antoraja/robo-to-roll/docs/02b-amazon-de.md

# 02b · Einkaufsliste / shopping list: amazon.de

Every link opens an **amazon.de search** for the right item, so you can pick a current
offer with good reviews. Prices are typical amazon.de prices (Nov 2026) and change often.

> **Why search links instead of single products?** Listings on amazon.de change and sell out
> all the time, and the exact product pages couldn't be checked from here. A search link
> always works. The "Pick" column says what to look for in the listing.

## Buy now: full hand (≈ €40–55)

| # | Item | Qty | Link | Pick | ≈ € |
|---|---|---|---|---|---|
| 1 | **MG90S servo**, metal gear, pack of 5–6 | 6 | [amazon.de: MG90S Servo 6 Stück](https://www.amazon.de/s?k=MG90S+Servo+Metallgetriebe+6+St%C3%BCck) | "MG90S" + "Metallgetriebe". Not SG90 (plastic gears) | 15–20 |
| 2 | **ESP32 DevKit** (ESP-WROOM-32, 30 pins) | 1 | [amazon.de: ESP32 NodeMCU Development Board](https://www.amazon.de/s?k=ESP32+NodeMCU+Development+Board+WROOM-32+30+pin) | AZ-Delivery or similar, **USB-C** if offered. A 2–3 pack is often only slightly more | 7–10 |
| 3 | **Jumper wires** M-M, M-F, F-F | 1 set | [amazon.de: Jumper Kabel Set](https://www.amazon.de/s?k=Jumper+Kabel+Set+male+female+120+St%C3%BCck) | **20 cm** (e.g. Elegoo 120 pcs). Only male-male is used: the ESP32 plugs into the breadboard, and 20 cm jumpers extend the 20 cm servo leads | 5–7 |
| 4 | **Breadboard**, 400 holes | 1 | [amazon.de: Breadboard 400](https://www.amazon.de/s?k=Breadboard+400+Kontakte) | 400 points (fits the tray in the stand). Packs of 3 are fine | 4–6 |
| 5 | **5 V / 3 A power supply** (barrel plug) | 1 | [amazon.de: Netzteil 5V 3A Hohlstecker](https://www.amazon.de/s?k=Netzteil+5V+3A+5.5x2.1+Hohlstecker) | 5.5 × 2.1 mm plug, ≥ 3 A | 8–11 |
| 6 | **DC socket → screw terminal adapter** | 1 | [amazon.de: DC Buchse Schraubklemme Adapter](https://www.amazon.de/s?k=DC+Buchse+5.5x2.1+Schraubklemme+Adapter) | Female 5.5 × 2.1 mm, packs of 5–10 | 4–6 |
| 7 | **Capacitor 1000 µF, 16 V** (Elko) | 1 | [amazon.de: Elko 1000uF 16V](https://www.amazon.de/s?k=Elko+1000uF+16V) | Any small pack | 4–6 |
| 8 | **Braided fishing line** 0.25–0.35 mm | 1 | [amazon.de: geflochtene Angelschnur 0,30 mm](https://www.amazon.de/s?k=geflochtene+Angelschnur+0%2C30mm) | **Geflochten** (braided PE), not monofil | 8–12 |
| 9 | **Round elastic cord, 2 mm** | 1 | [amazon.de: Gummikordel rund 2 mm](https://www.amazon.de/s?k=Gummikordel+rund+2mm) | Round, rubber core, 2 mm (also sold as "Hutgummi 2mm") | 5–7 |
| 10 | **USB data cable** for the ESP32 | 1 | [amazon.de: USB C Datenkabel](https://www.amazon.de/s?k=USB+C+Datenkabel+kurz) | Match your board (USB-C or Micro-USB). It must say **Daten** (data). You probably have one | 0–6 |

**Already at home:** PLA (~330 g), 1.75 mm filament for the pins, super glue
(Sekundenkleber), a lighter, a small Phillips screwdriver, scissors, and 4 coins (2-euro
coins fit the stand's pockets).

## Camera in the palm (guide 06, ≈ €15–20)

| Item | Link | Pick | ≈ € |
|---|---|---|---|
| **ESP32-CAM with ESP32-CAM-MB** programmer | [amazon.de: ESP32-CAM MB](https://www.amazon.de/s?k=ESP32-CAM+MB+OV2640) | AI-Thinker ESP32-CAM **with** the MB USB board | 10–14 |
| **Jumper wires female-male, 40 cm** | [amazon.de: Jumper Kabel female male 40cm](https://www.amazon.de/s?k=Jumper+Kabel+female+male+40cm) | 2 needed (5 V + GND up to the palm) | 4–6 |

## Optional, saves time

| Item | Link | ≈ € |
|---|---|---|
| Servo extension cables 30 cm (neater than jumper wires; not required) | [amazon.de: Servo Verlängerungskabel 30cm](https://www.amazon.de/s?k=Servo+Verl%C3%A4ngerungskabel+30cm) | 5–7 |
| 2 mm drill bit (cleans tight pin holes) | [amazon.de: Bohrer 2mm HSS](https://www.amazon.de/s?k=HSS+Bohrer+2mm) | 4–6 |
| Cheap multimeter | [amazon.de: Multimeter digital](https://www.amazon.de/s?k=Multimeter+digital+g%C3%BCnstig) | 10–15 |
| Hot glue gun (non-slip feet, grip pads) | [amazon.de: Heißklebepistole klein](https://www.amazon.de/s?k=Hei%C3%9Fklebepistole+klein) | 8–12 |

## Later: rolling stage (don't buy yet)

| Item | Link | ≈ € |
|---|---|---|
| Manual rolling machine, 70 mm | [amazon.de: Drehmaschine Zigaretten 70mm](https://www.amazon.de/s?k=Zigaretten+Drehmaschine+70mm) | 3–8 |
| Thin pressure sensors FSR402 | [amazon.de: FSR402 Drucksensor](https://www.amazon.de/s?k=FSR402+Drucksensor) | 8–12 (pack) |
| MG996R servos for the wrist | [amazon.de: MG996R Servo](https://www.amazon.de/s?k=MG996R+Servo) | 12–18 (2-pack) |
