antoraja/robo-to-roll/docs/img/elastic_corner.png

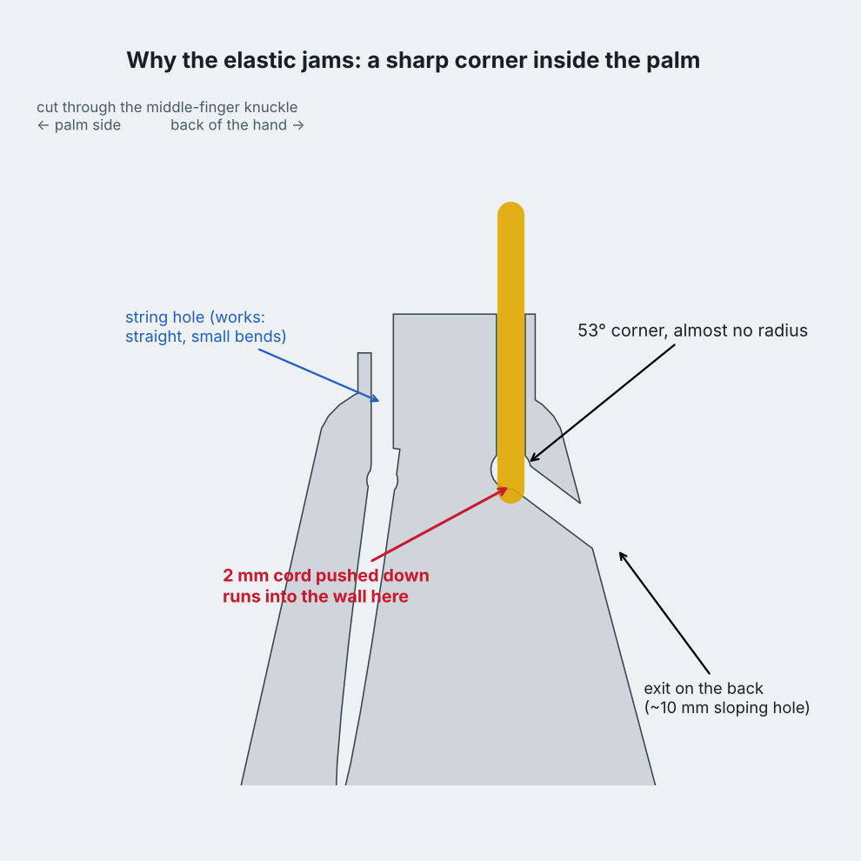
docs/img/elastic_corner.png
