antoraja/robo-to-roll/docs/img/finger_preview.png

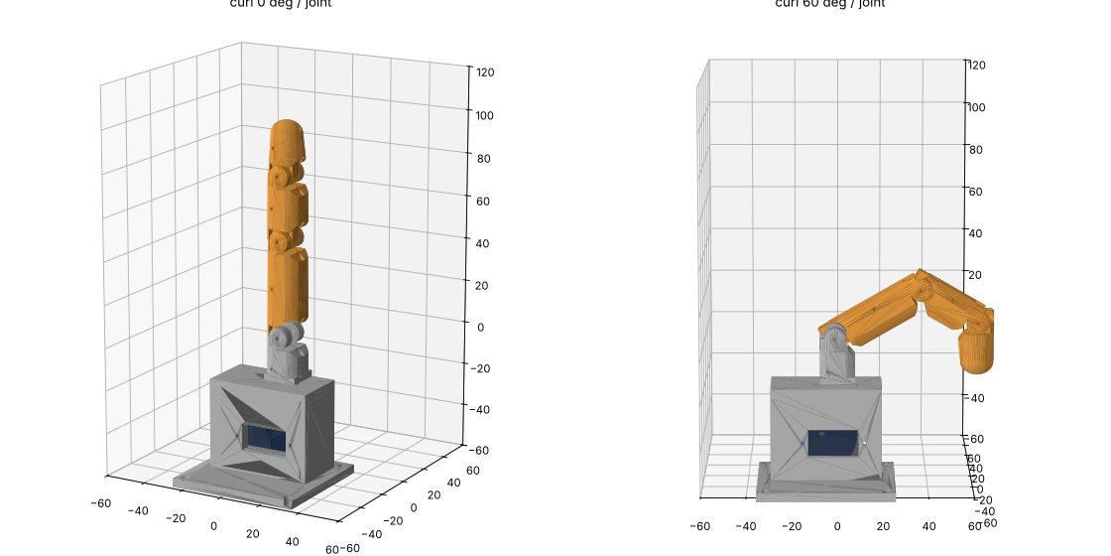
docs/img/finger_preview.png
