antoraja/robo-to-roll/docs/img/spine_servo_sides.png

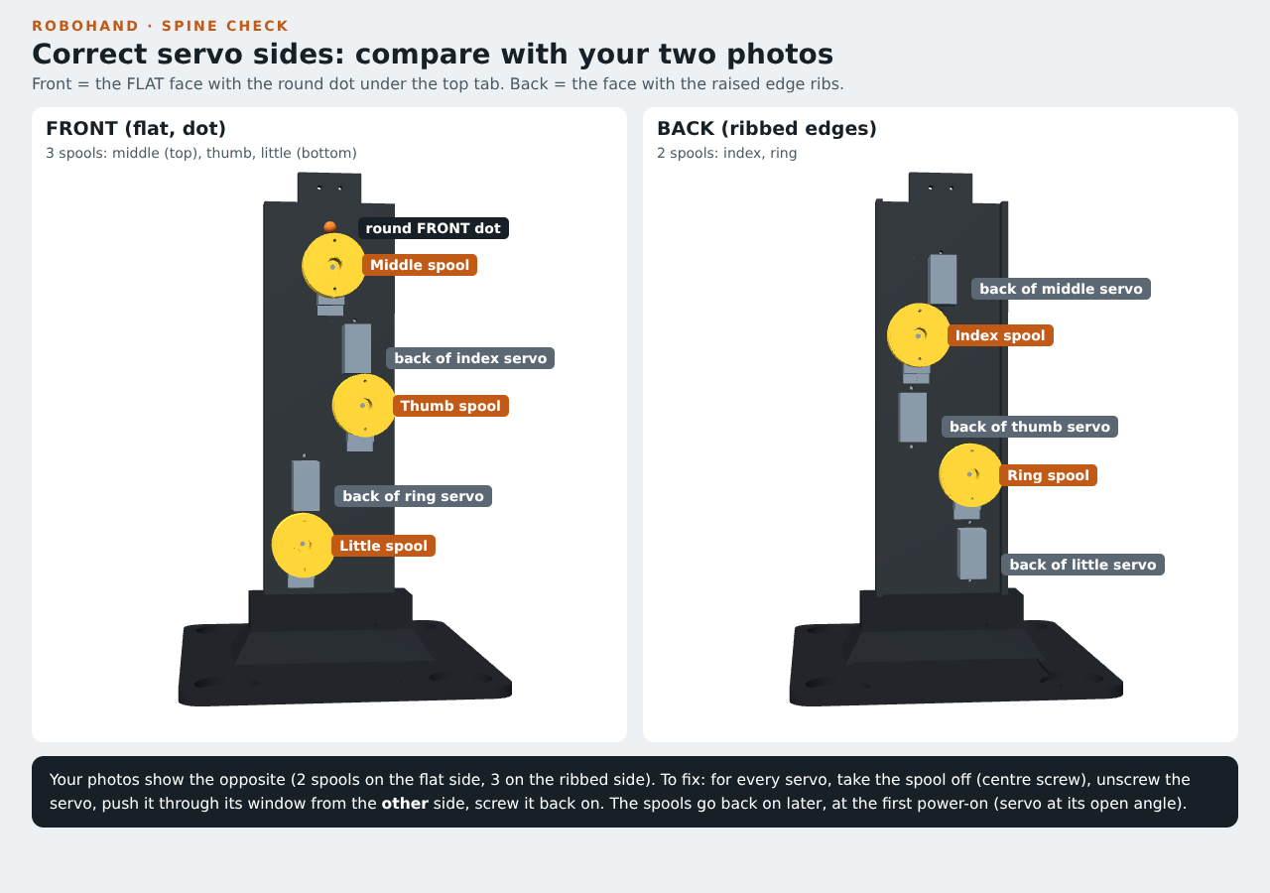
docs/img/spine_servo_sides.png
