antoraja/robo-to-roll/docs/img/spool_v2_design.png

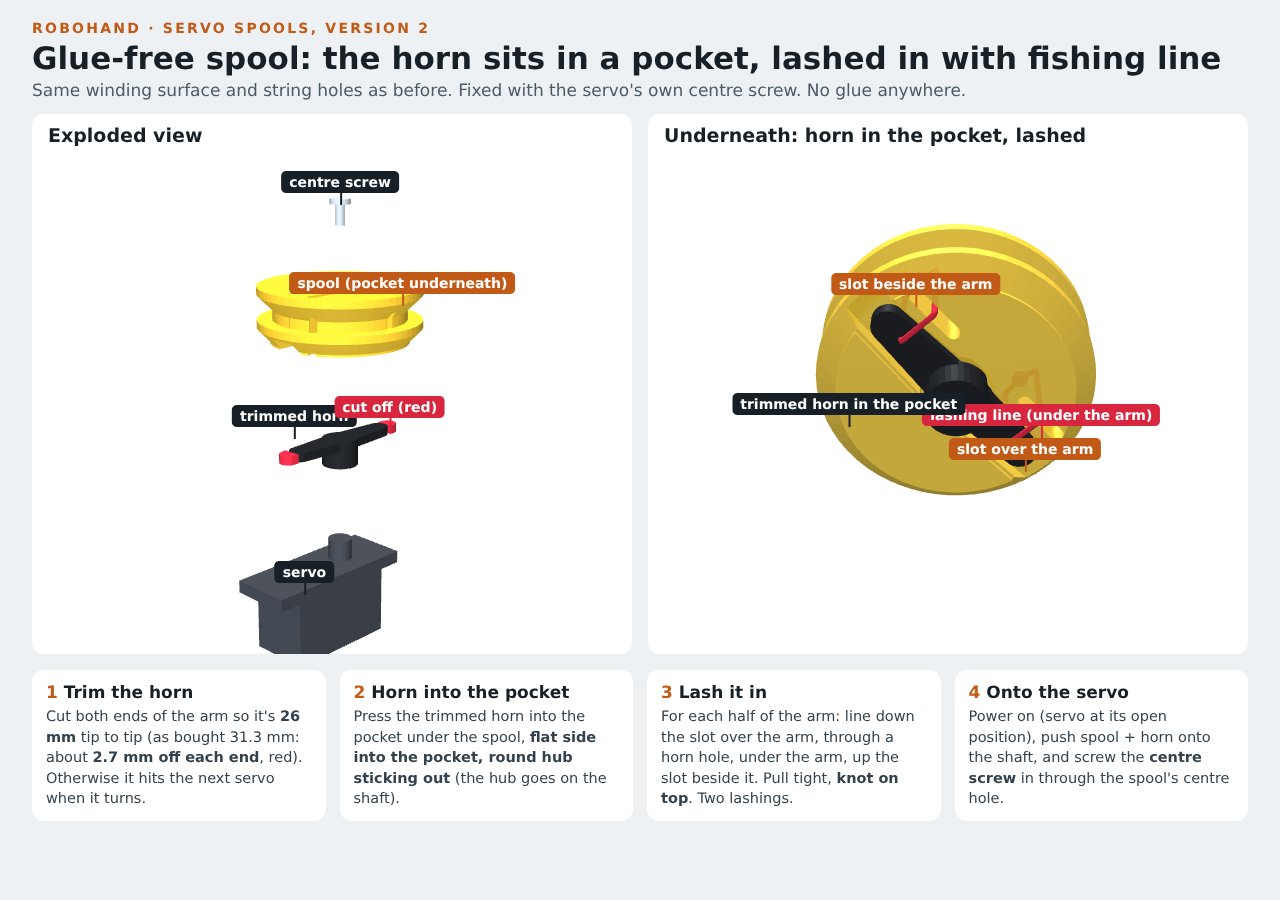
docs/img/spool_v2_design.png
