antoraja/robo-to-roll/docs/img/spool_v3_checked.png

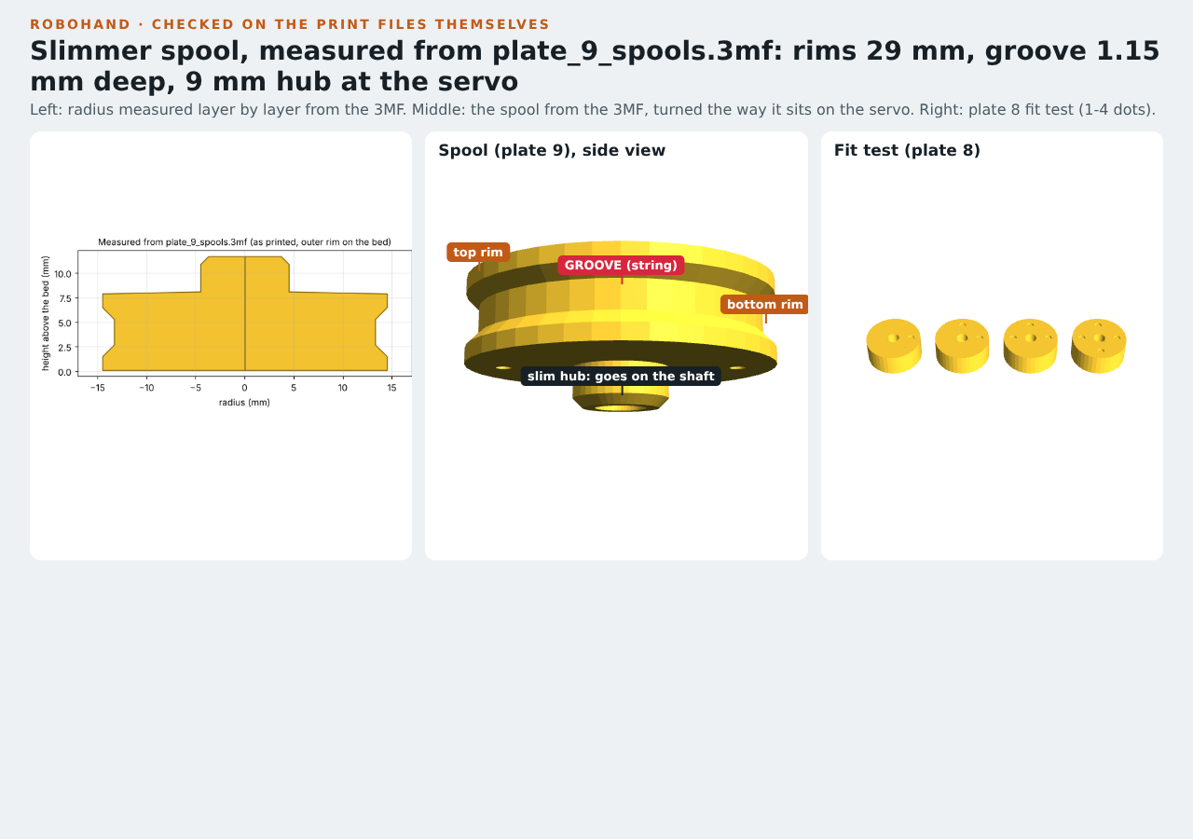
docs/img/spool_v3_checked.png
