antoraja/robo-to-roll/docs/img/spool_v3_design.png

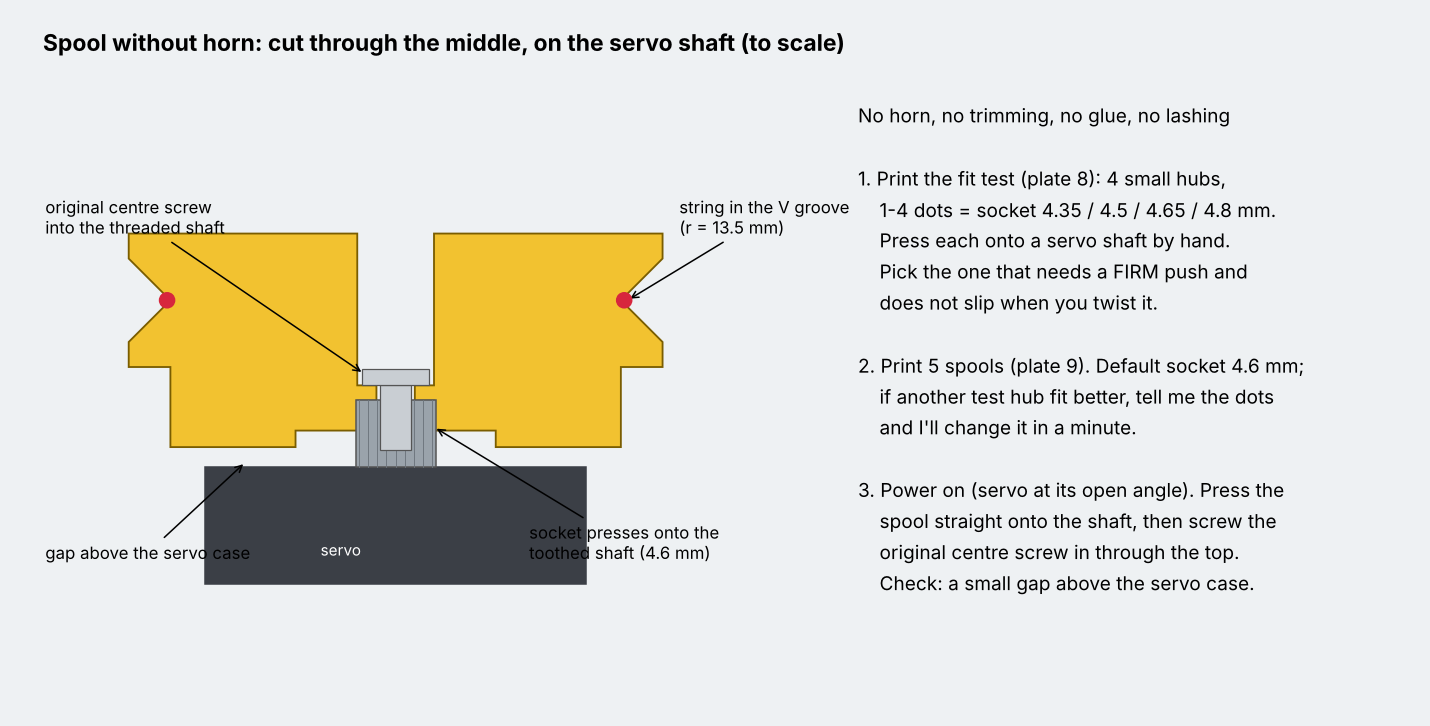
docs/img/spool_v3_design.png
