antoraja/robo-to-roll/docs/img/spool_v3_views.png

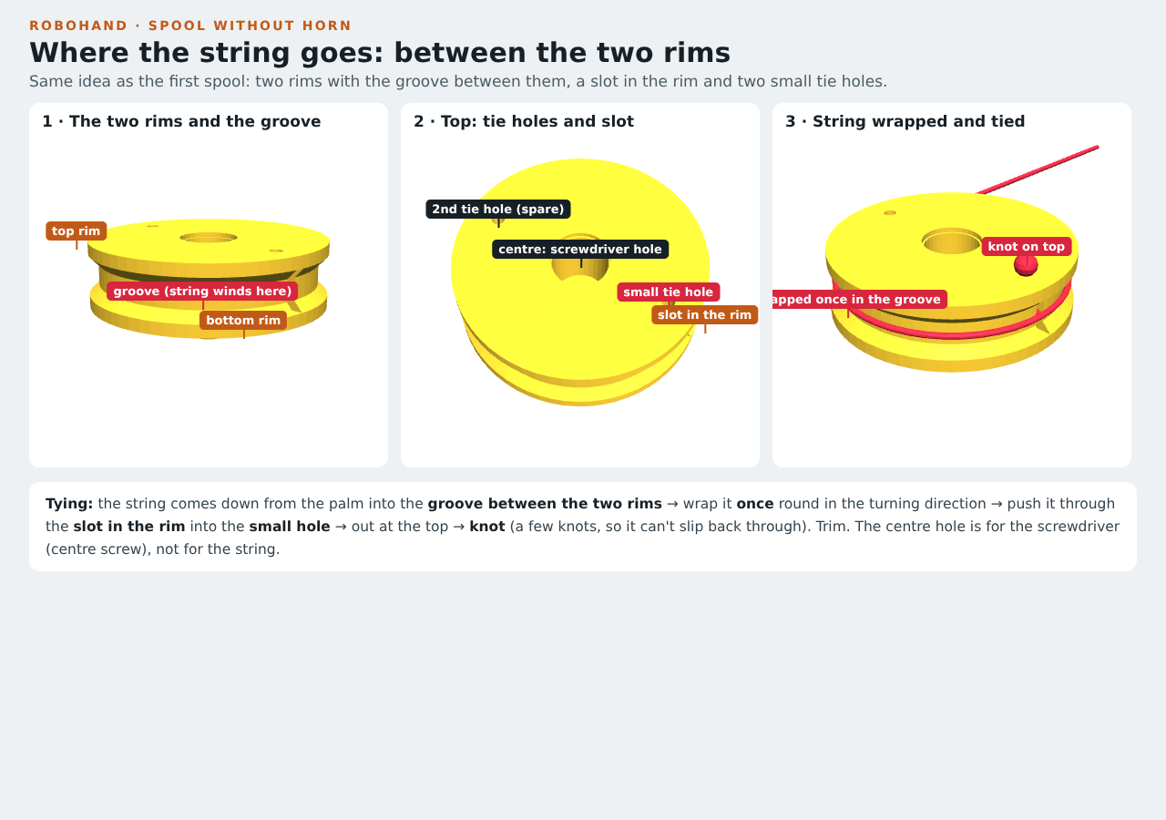
docs/img/spool_v3_views.png
