antoraja/robo-to-roll/docs/img/spool_versions.png

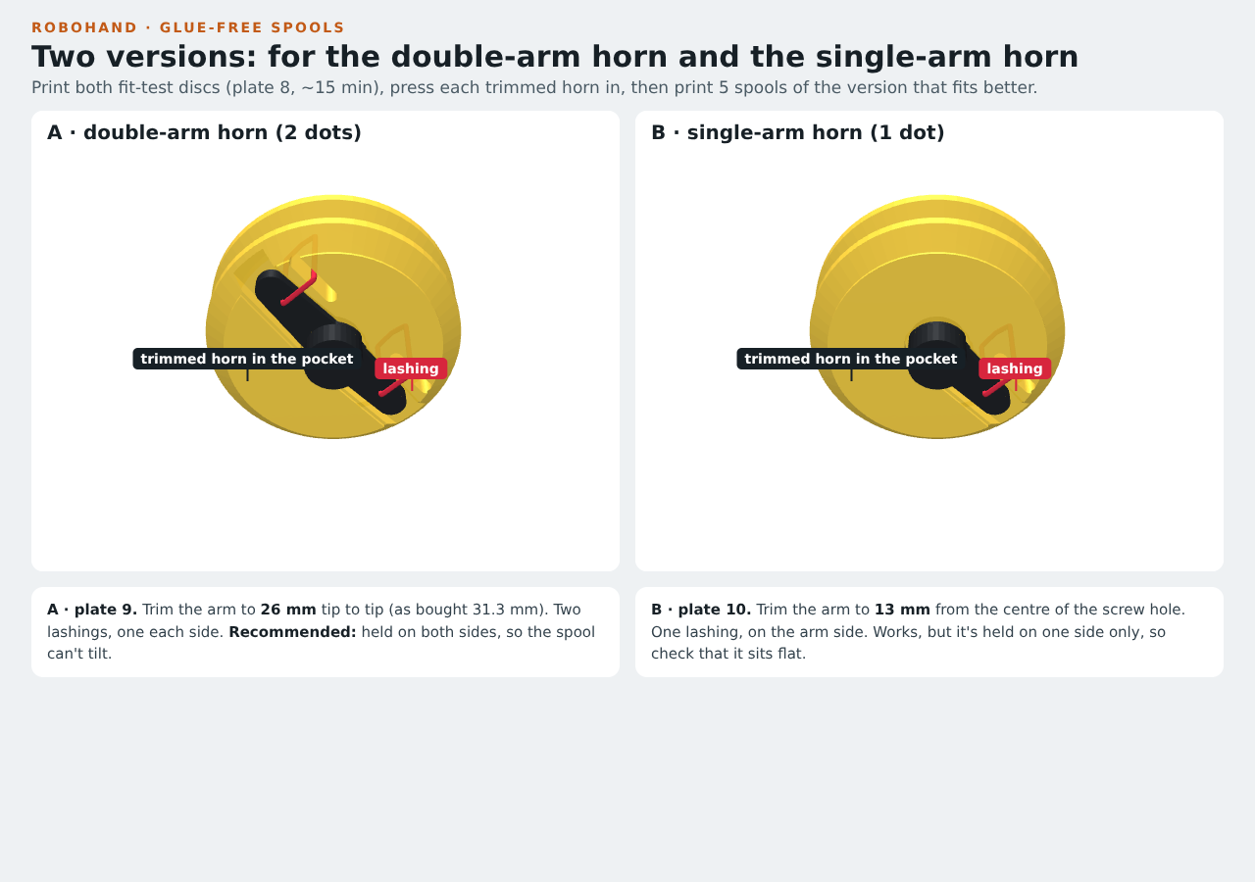
docs/img/spool_versions.png
