antoraja/robo-to-roll/docs/reference/design/elastic_knot_at_palm.png

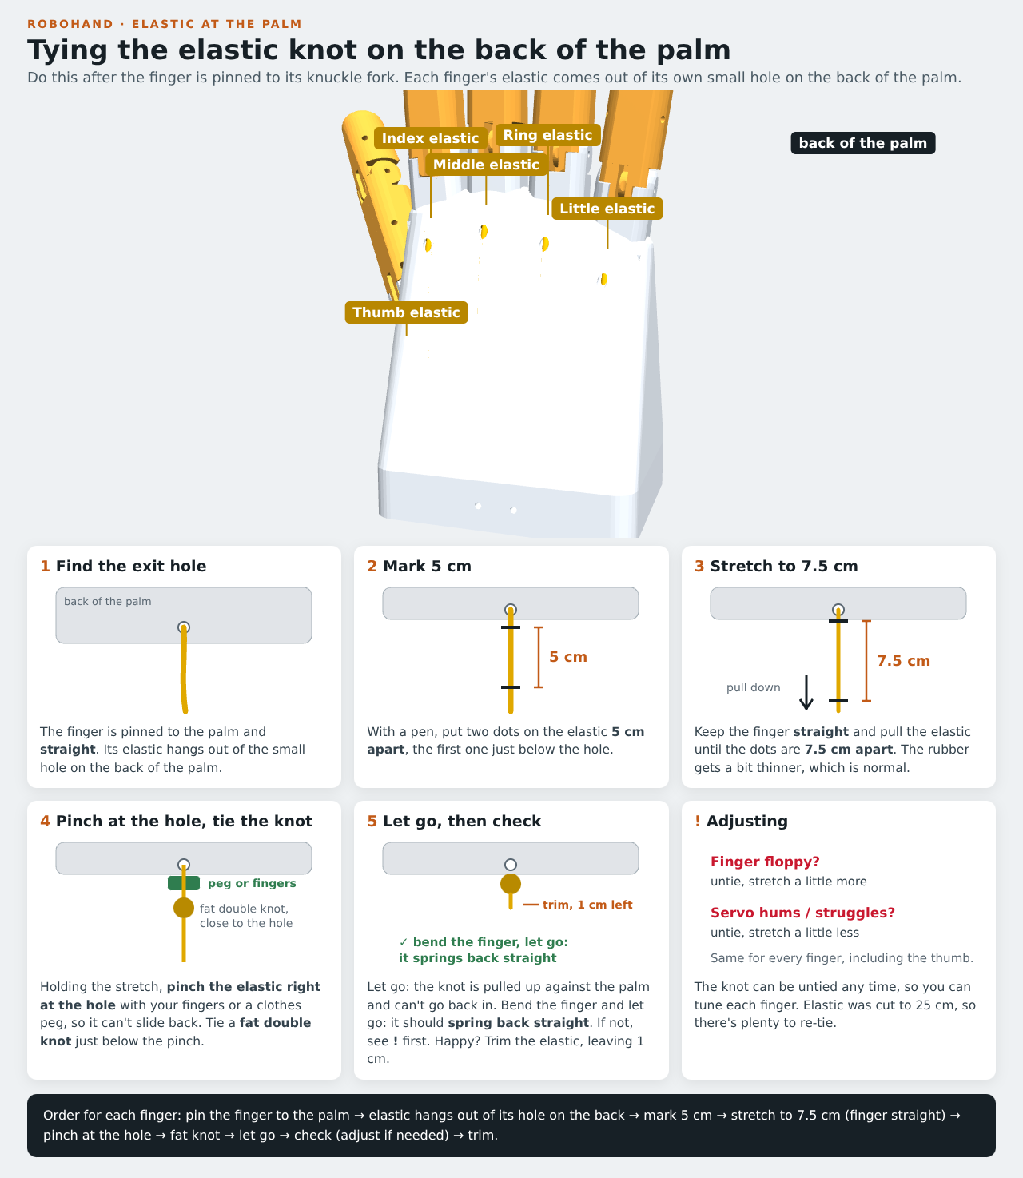
docs/reference/design/elastic_knot_at_palm.png
