antoraja/robo-to-roll/docs/reference/design/finger_pin_slot.png

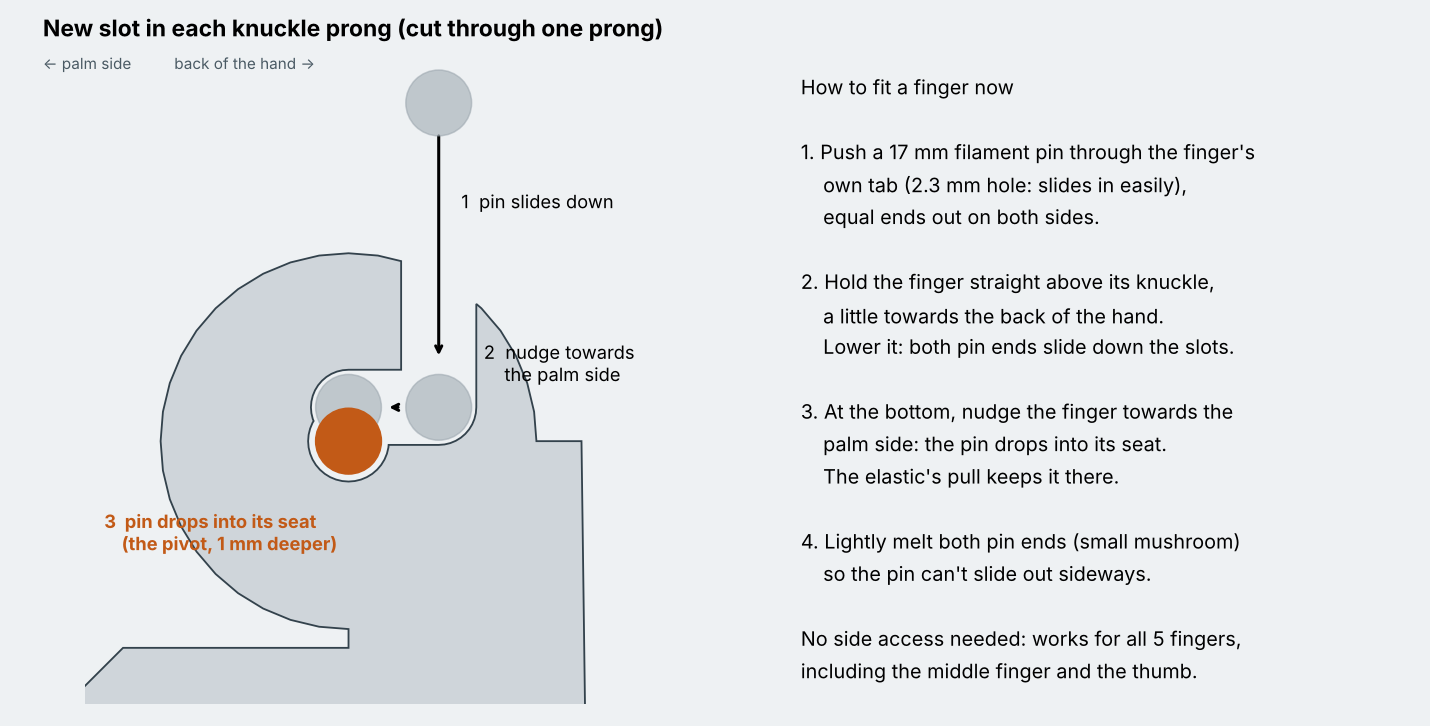
docs/reference/design/finger_pin_slot.png
