antoraja/robo-to-roll/docs/reference/photos/2026-11-02_fingers_correct_layout.jpg

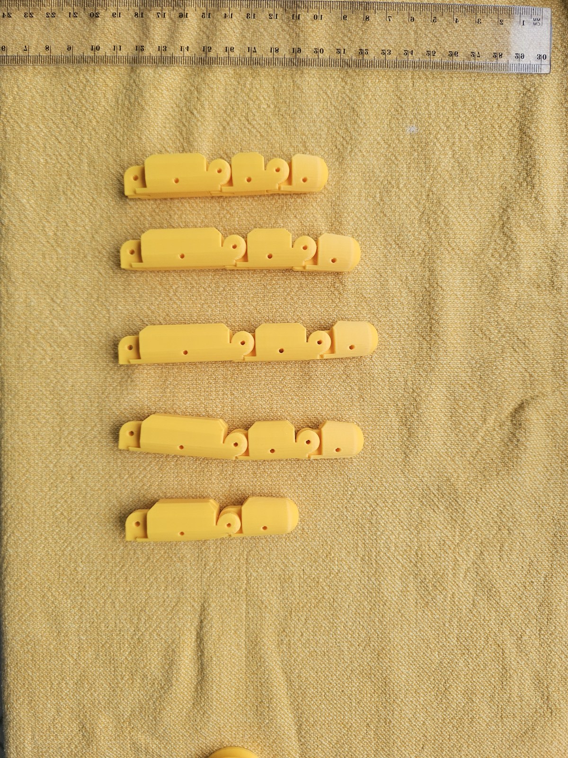
docs/reference/photos/2026-11-02_fingers_correct_layout.jpg
