antoraja/robo-to-roll/video/spool_v3/profile.png

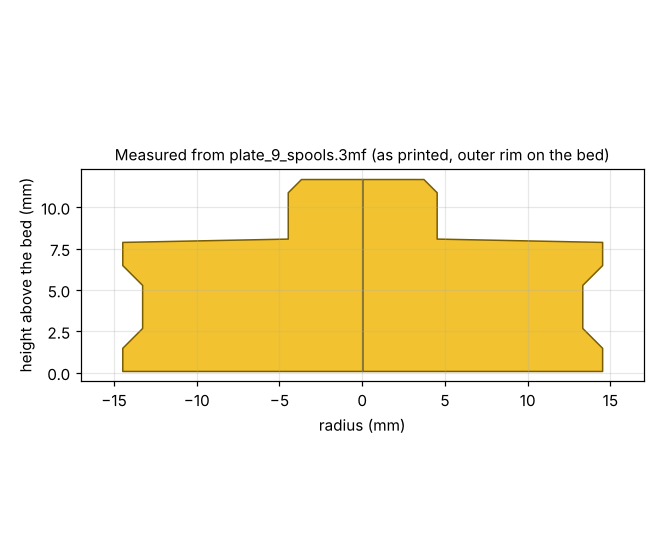
video/spool_v3/profile.png
