antoraja/robo-to-roll/cad/assembly/robohand_assembly.stl

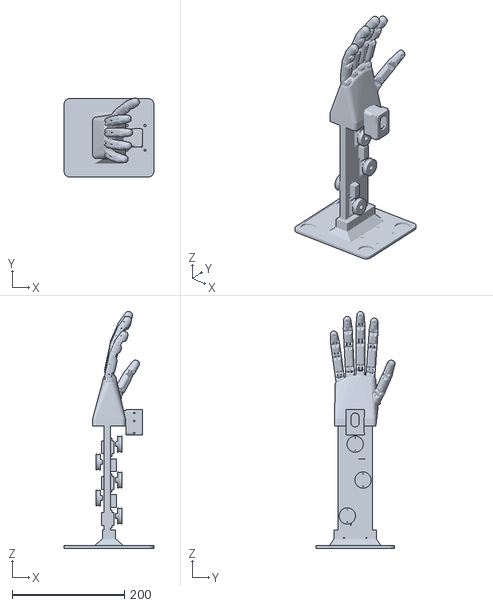
[picture p15: CAD file, 2026-11-11]
cad/assembly/robohand_assembly.stl
160.0 x 141.2 x 422.4
