antoraja/robo-to-roll/cad/plates/plate_1_fit_test.3mf

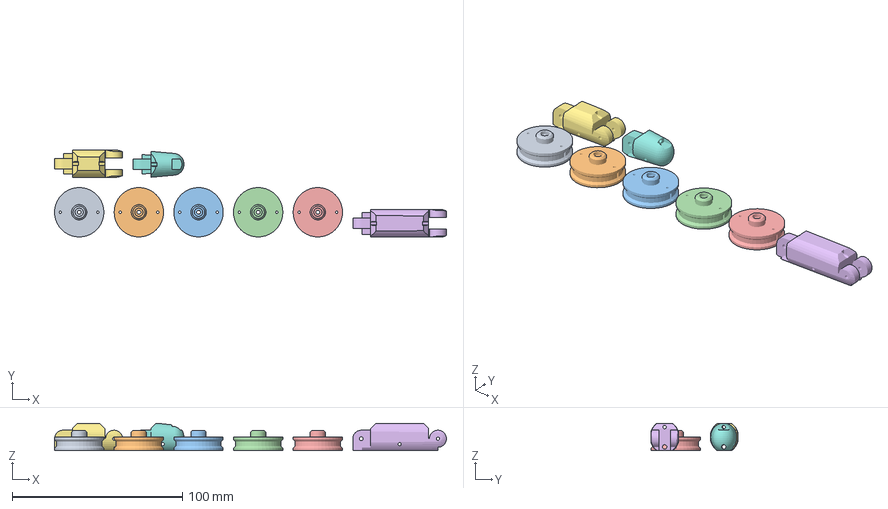
[picture p16: CAD file, 2026-11-11]
cad/plates/plate_1_fit_test.3mf
230.0 x 51.0 x 16.0 mm
spool_1
spool_2
spool_3
spool_4
spool_5
index_proximal
index_middle
index_distal
