antoraja/robo-to-roll/cad/stl/camera/palm_camera_cover.stl

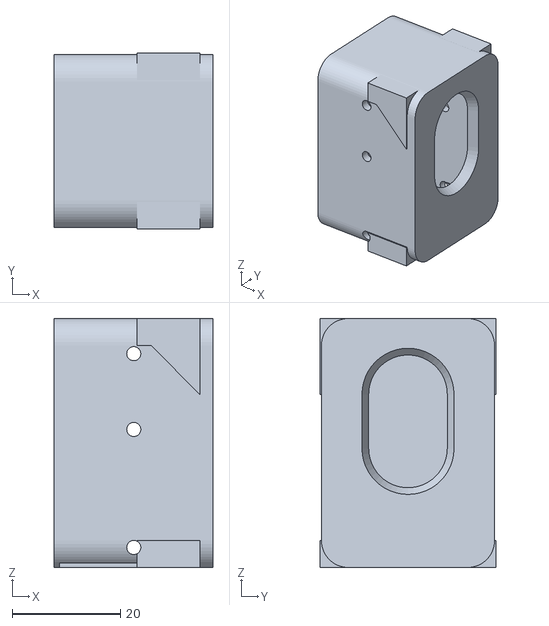
[picture p17: CAD file, 2026-11-04]
cad/stl/camera/palm_camera_cover.stl
29.3 x 32.6 x 46.0
