antoraja/robo-to-roll/cad/stl/finger_distal.stl

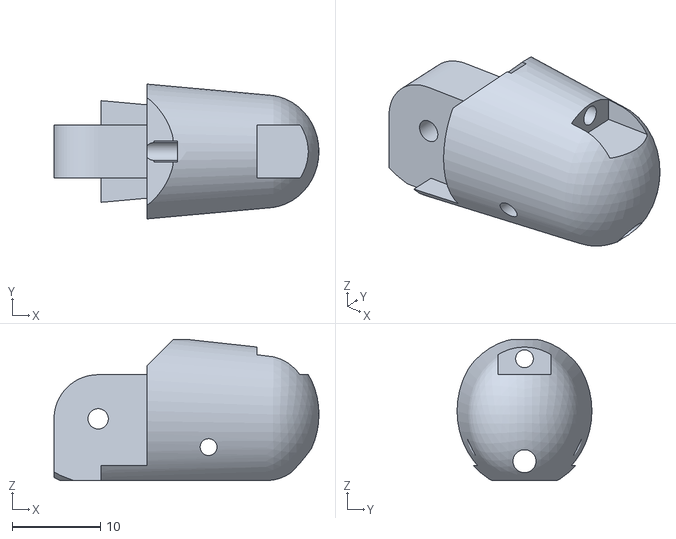
[picture p18: CAD file, 2026-11-03]
cad/stl/finger_distal.stl
30.0 x 15.3 x 16.0
