antoraja/robo-to-roll/cad/stl/hand/servo_spool_x5.stl

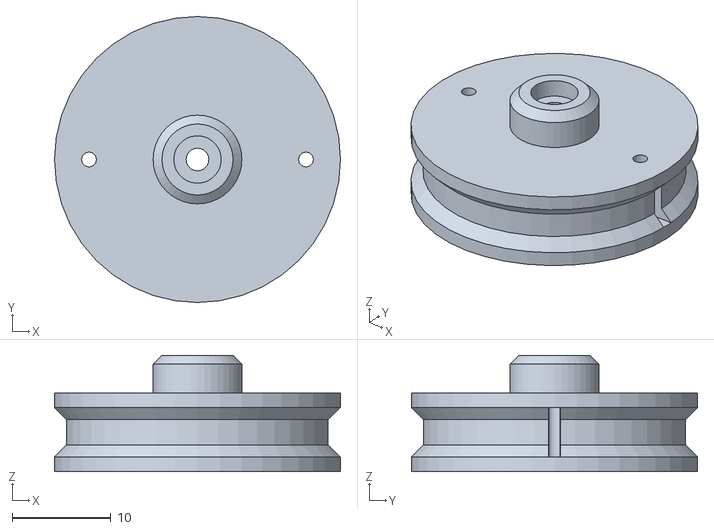
[picture p19: CAD file, 2026-11-11]
cad/stl/hand/servo_spool_x5.stl
29.0 x 29.0 x 11.8
