antoraja/robo-to-roll/cad/plates/plate_9_spools.3mf

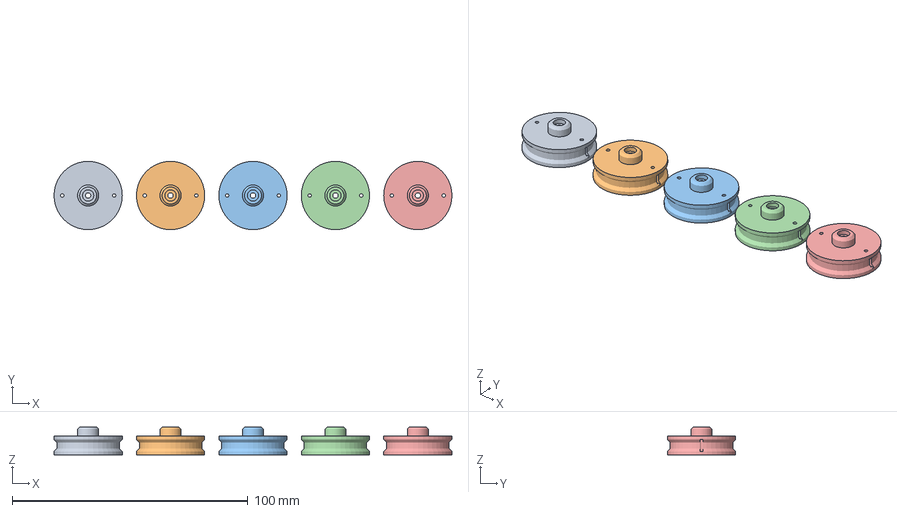
[picture p20: CAD file, 2026-11-11]
cad/plates/plate_9_spools.3mf
169.0 x 29.0 x 11.8 mm
spool_1
spool_2
spool_3
spool_4
spool_5
