antoraja/robo-to-roll/cad/stl/hand/spline_fit_test.stl

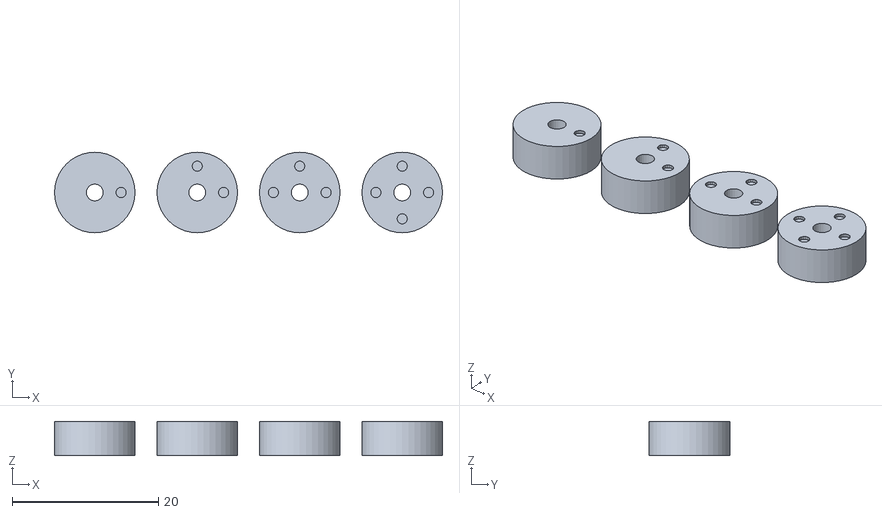
[picture p21: CAD file, 2026-11-10]
cad/stl/hand/spline_fit_test.stl
53.0 x 11.0 x 4.70
