antoraja/robo-to-roll/cad/stl/tip_cap_index.stl

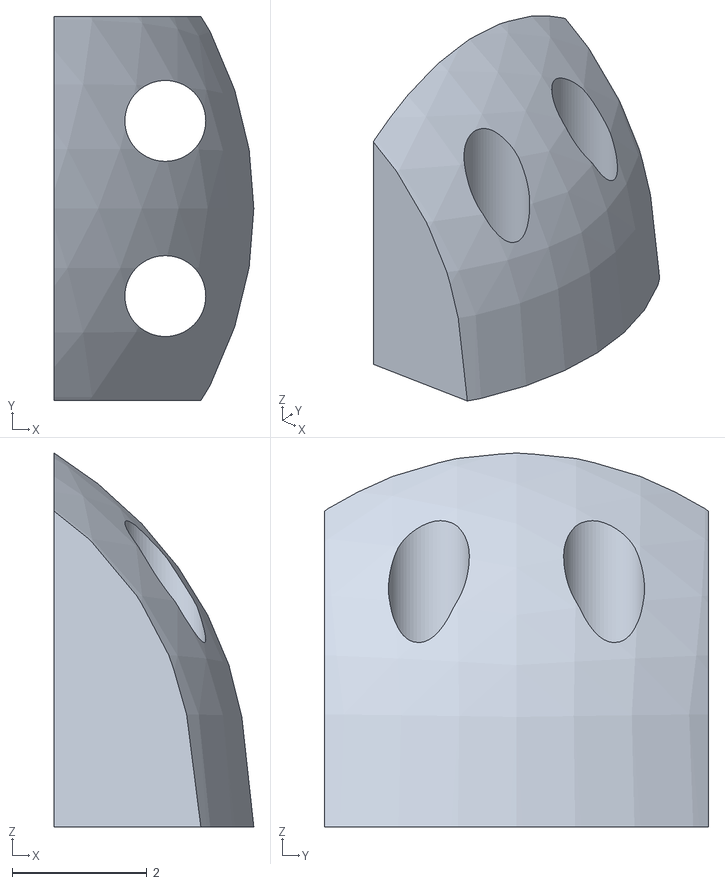
[picture p22: CAD file, 2026-11-03]
cad/stl/tip_cap_index.stl
2.96 x 5.70 x 5.55
