antoraja/robo-to-roll/cad/stl/hand/palm.stl

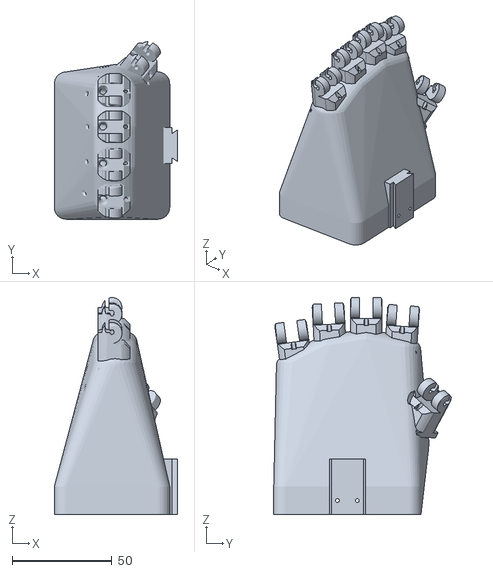
[picture p23: CAD file, 2026-11-04]
cad/stl/hand/palm.stl
62.0 x 89.2 x 109.0
