antoraja/robo-to-roll/cad/stl/servo_spool.stl

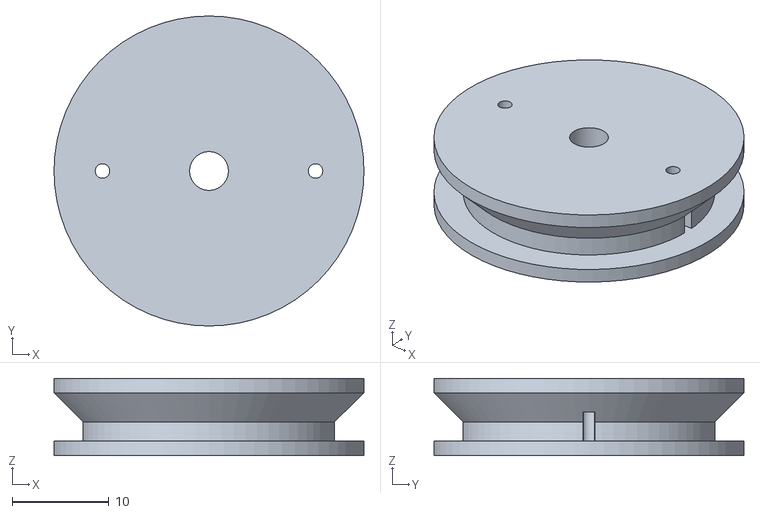
[picture p24: CAD file, 2026-11-01]
cad/stl/servo_spool.stl
32.0 x 32.0 x 8.00
