antoraja/robo-to-roll/cad/stl/finger_proximal.stl

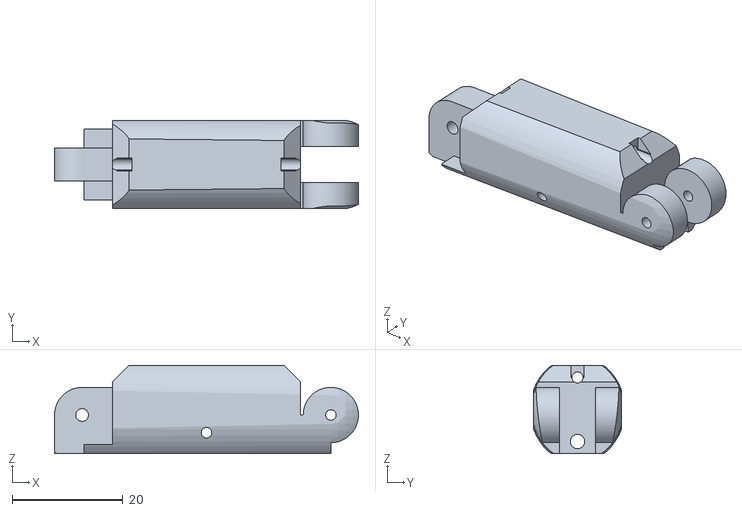
[picture p25: CAD file, 2026-11-01]
cad/stl/finger_proximal.stl
55.0 x 16.0 x 16.0
