antoraja/robo-to-roll/cad/stl/hand/little_distal.stl

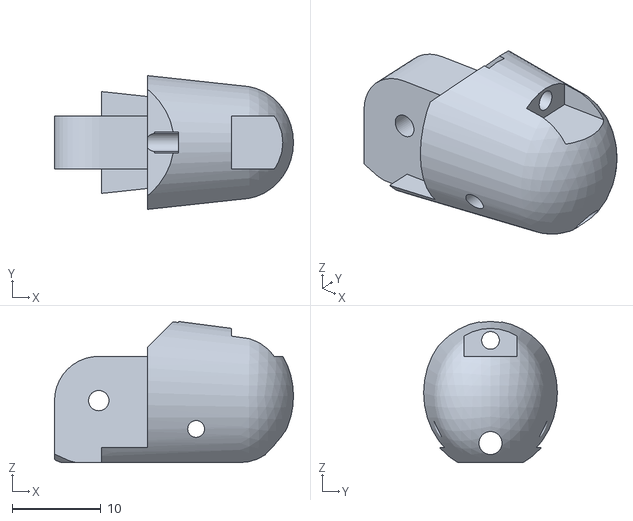
[picture p26: CAD file, 2026-11-03]
cad/stl/hand/little_distal.stl
27.0 x 15.1 x 15.9
