antoraja/robo-to-roll/cad/stl/finger_middle.stl

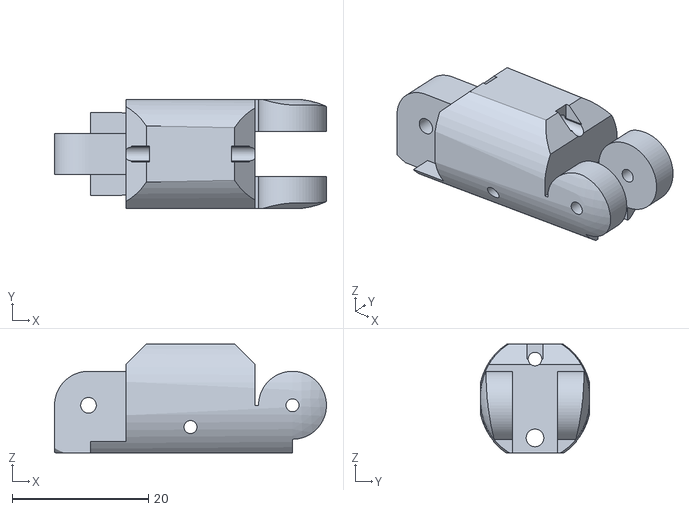
[picture p27: CAD file, 2026-11-01]
cad/stl/finger_middle.stl
40.0 x 16.0 x 16.0
