antoraja/robo-to-roll/cad/plates/plate_2_fingers.3mf

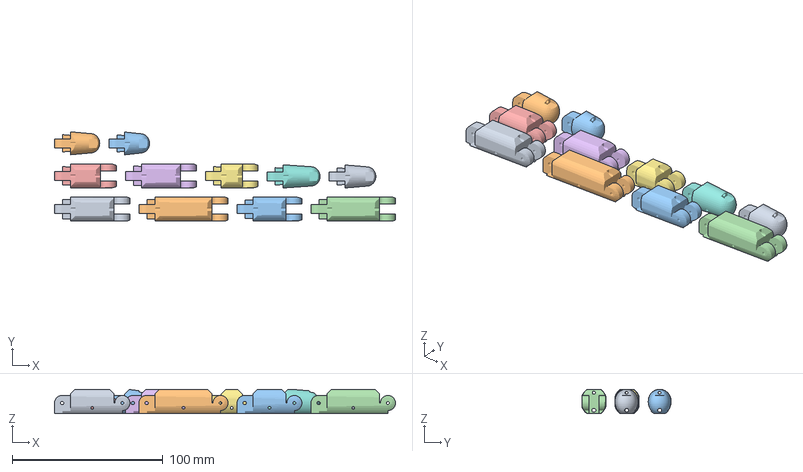
[picture p28: CAD file, 2026-11-03]
cad/plates/plate_2_fingers.3mf
226.0 x 59.3 x 16.0 mm
thumb_proximal
middle_proximal
middle_middle
ring_proximal
ring_middle
little_proximal
little_middle
thumb_distal
middle_distal
ring_distal
little_distal
