antoraja/robo-to-roll/cad/stl/finger_base.stl

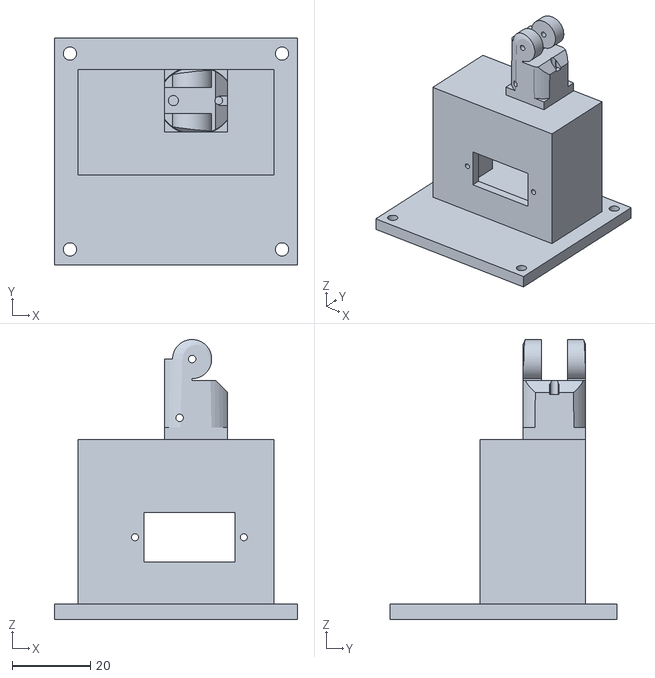
[picture p29: CAD file, 2026-11-01]
cad/stl/finger_base.stl
62.2 x 58.0 x 71.5
