antoraja/robo-to-roll/cad/stl/hand/middle_distal.stl

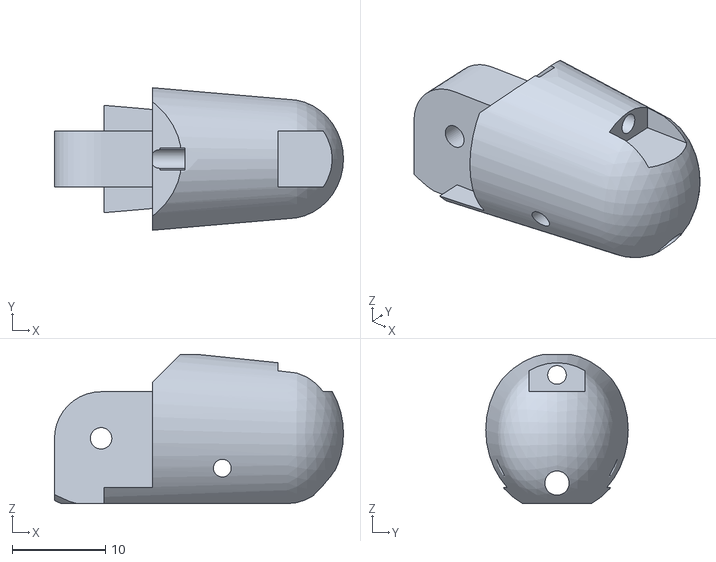
[picture p30: CAD file, 2026-11-03]
cad/stl/hand/middle_distal.stl
31.0 x 15.3 x 16.0
