antoraja/robo-to-roll/cad/plates/plate_4_spine.3mf

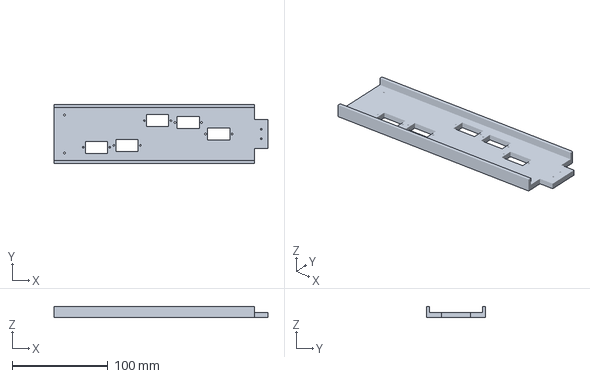
[picture p31: CAD file, 2026-11-03]
cad/plates/plate_4_spine.3mf
224.0 x 62.0 x 11.5 mm
