antoraja/robo-to-roll/cad/stl/hand/thumb_distal.stl

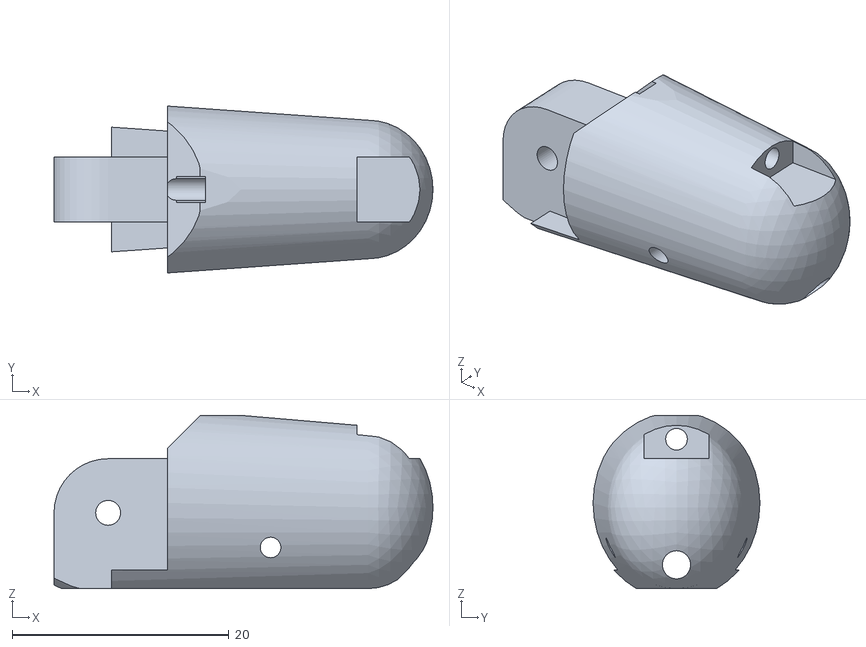
[picture p32: CAD file, 2026-11-03]
cad/stl/hand/thumb_distal.stl
35.0 x 15.4 x 16.0
