antoraja/robo-to-roll/cad/plates/plate_6_tips_and_caps.3mf

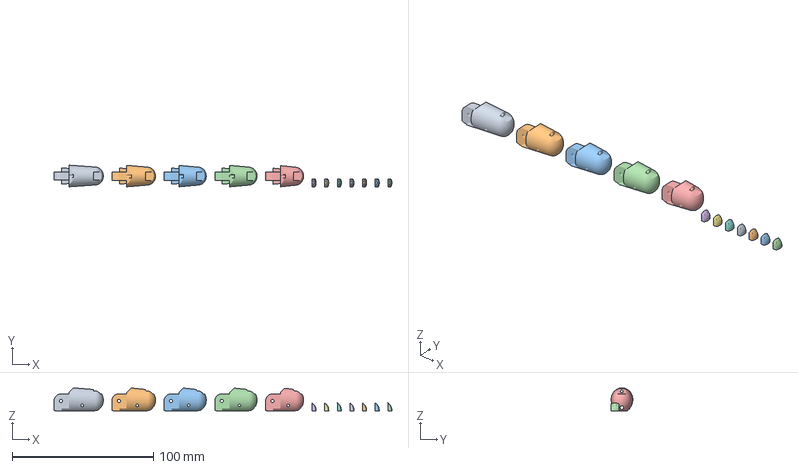
[picture p33: CAD file, 2026-11-03]
cad/plates/plate_6_tips_and_caps.3mf
239.7 x 15.4 x 16.0 mm
thumb_distal
middle_distal
index_distal
ring_distal
little_distal
thumb_tip_cap
index_tip_cap
middle_tip_cap
ring_tip_cap
little_tip_cap
spare_tip_cap_1
spare_tip_cap_2
