antoraja/robo-to-roll/cad/plates/plate_5_stand.3mf

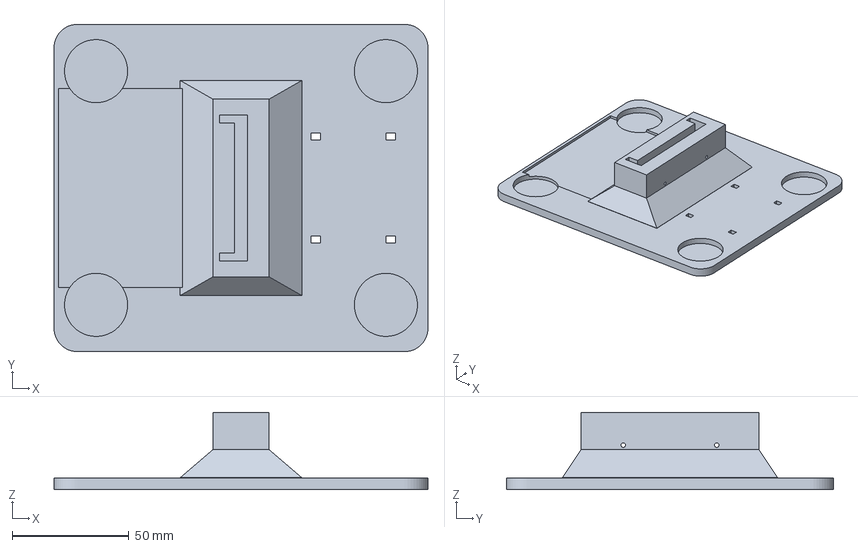
[picture p34: CAD file, 2026-11-03]
cad/plates/plate_5_stand.3mf
160.0 x 140.0 x 33.0 mm
