antoraja/robo-to-roll/cad/stl/hand/ring_proximal.stl

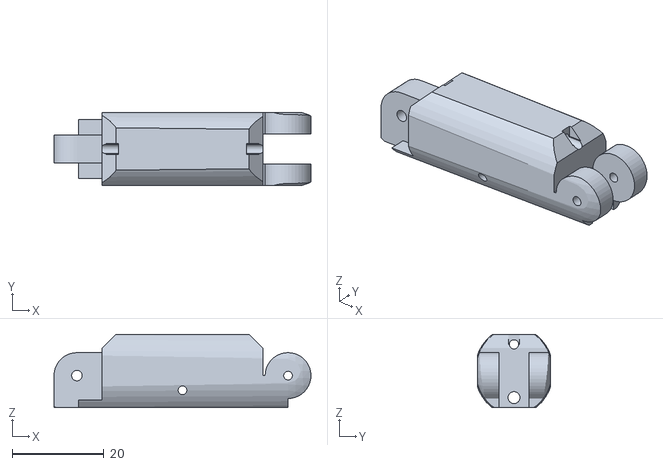
[picture p35: CAD file, 2026-11-01]
cad/stl/hand/ring_proximal.stl
56.0 x 16.0 x 16.0
