antoraja/robo-to-roll/cad/stl/hand/ring_middle.stl

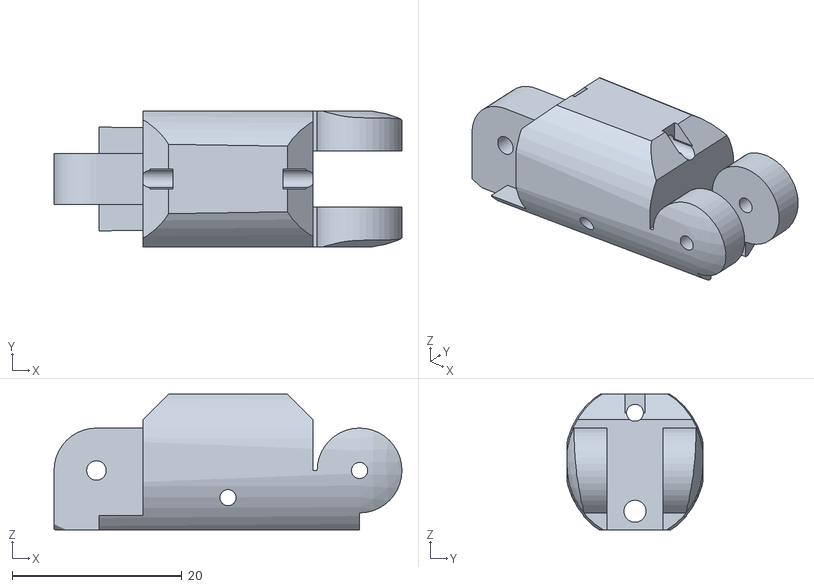
[picture p36: CAD file, 2026-11-01]
cad/stl/hand/ring_middle.stl
41.0 x 16.0 x 16.0
