antoraja/robo-to-roll/cad/stl/hand/middle_middle.stl

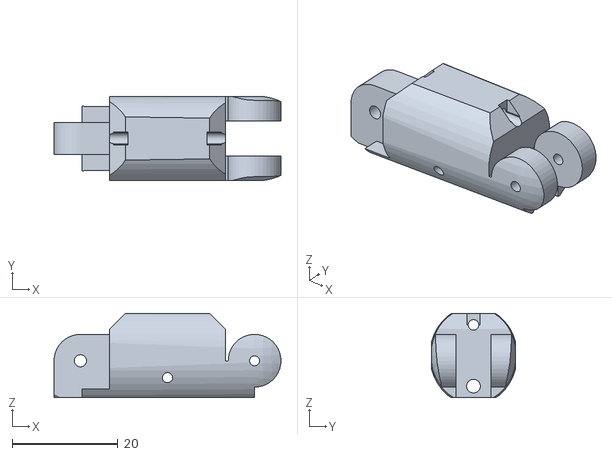
[picture p37: CAD file, 2026-11-01]
cad/stl/hand/middle_middle.stl
43.0 x 16.0 x 16.0
