antoraja/robo-to-roll/cad/stl/hand/thumb_proximal.stl

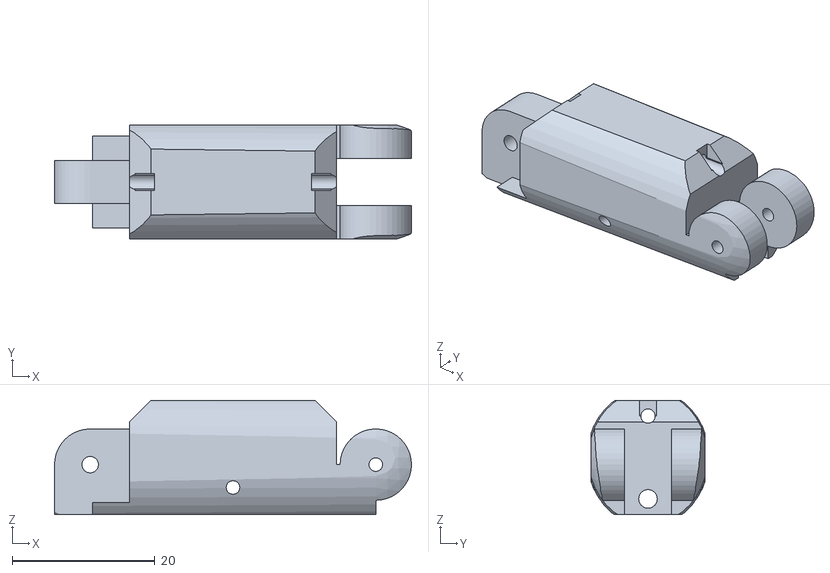
[picture p38: CAD file, 2026-11-01]
cad/stl/hand/thumb_proximal.stl
50.0 x 16.0 x 16.0
