antoraja/robo-to-roll/cad/stl/hand/middle_proximal.stl

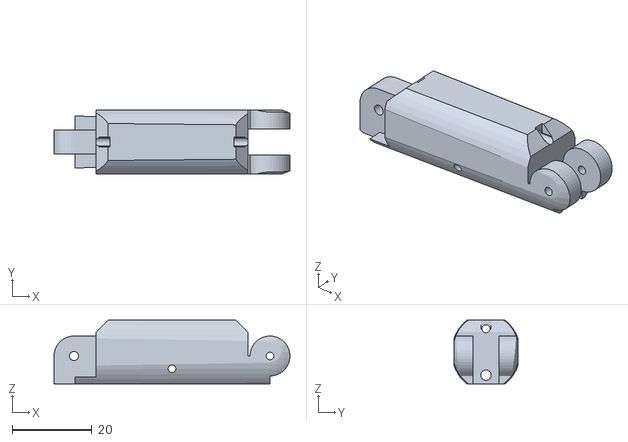
[picture p39: CAD file, 2026-11-01]
cad/stl/hand/middle_proximal.stl
59.0 x 16.0 x 16.0
