antoraja/robo-to-roll/cad/stl/hand/little_proximal.stl

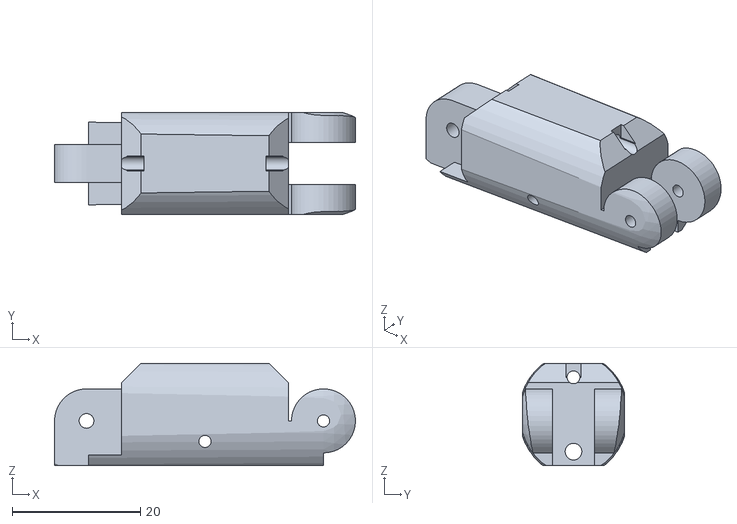
[picture p40: CAD file, 2026-11-01]
cad/stl/hand/little_proximal.stl
47.0 x 16.0 x 16.0
