antoraja/robo-to-roll/cad/stl/hand/little_middle.stl

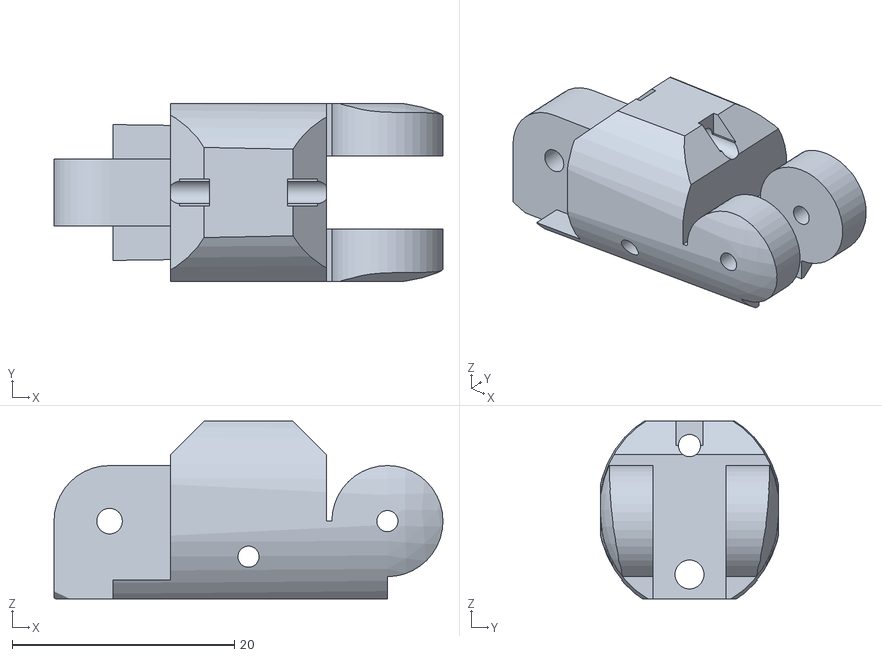
[picture p41: CAD file, 2026-11-01]
cad/stl/hand/little_middle.stl
35.0 x 16.0 x 16.0
