antoraja/robo-to-roll/(list of files, cad)

Other CAD files:
cad/plates/plate_8_spline_fit_test.3mf
cad/plates/plate_3_palm.3mf
cad/plates/plate_7_palm_camera.3mf
cad/stl/hand/ring_distal.stl
cad/stl/hand/index_distal.stl
cad/stl/hand/stand.stl
cad/stl/hand/spine.stl
cad/stl/hand/index_middle.stl
cad/stl/hand/index_proximal.stl
cad/plates/plate_1_fit_test.stl
cad/plates/plate_2_fingers.stl
cad/plates/plate_4_spine.stl
cad/plates/plate_5_stand.stl
cad/plates/plate_6_tips_and_caps.stl
cad/plates/plate_7_palm_camera.stl
cad/plates/plate_9_spools.stl
