antoraja/robo-to-roll/docs/reference/design/spool_tie_steps.png

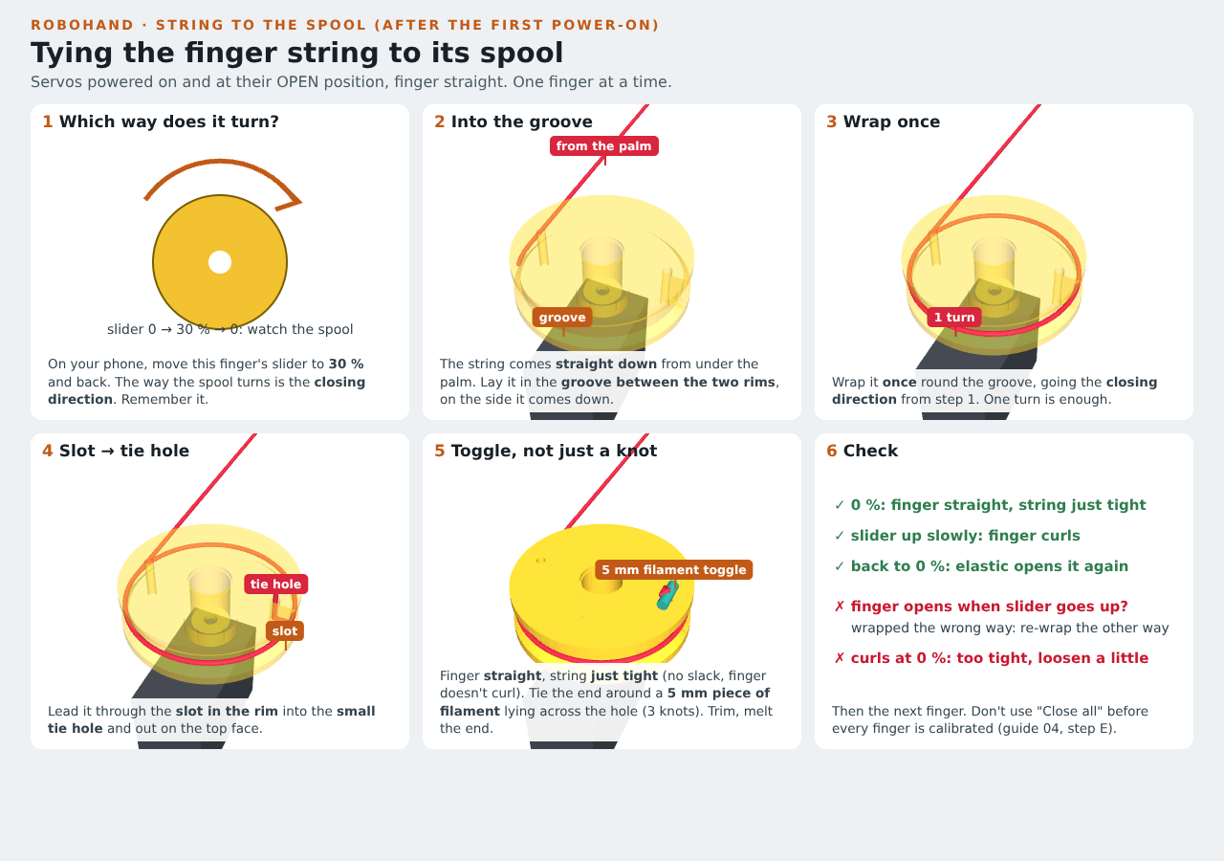
docs/reference/design/spool_tie_steps.png
