antoraja/robo-to-roll/docs/reference/photos/2026-11-05_assembled_hand_front.jpg

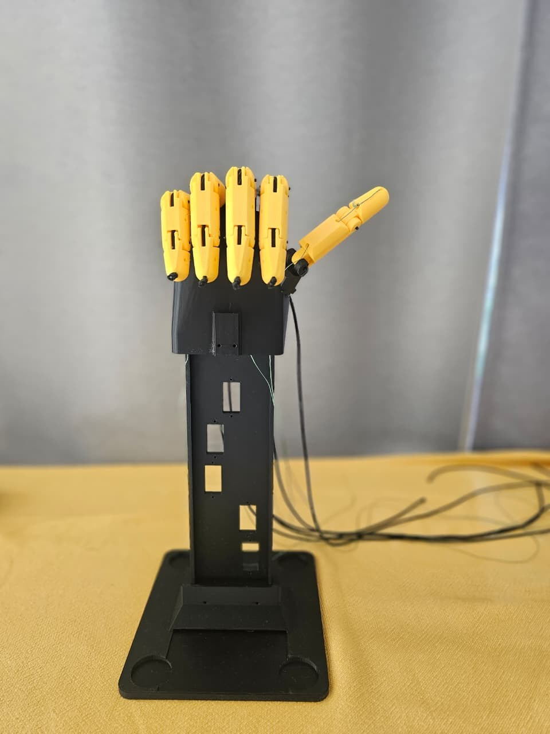
docs/reference/photos/2026-11-05_assembled_hand_front.jpg
