antoraja/robo-to-roll/docs/img/palm_channel_fix.png

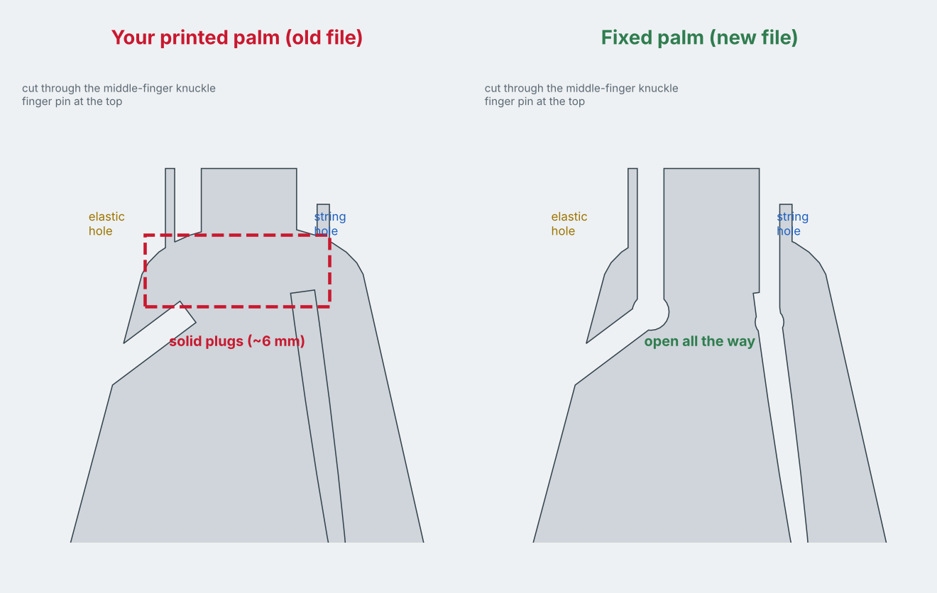
docs/img/palm_channel_fix.png
