antoraja/robo-to-roll/docs/reference/design/elastic_tunnel_fix.png

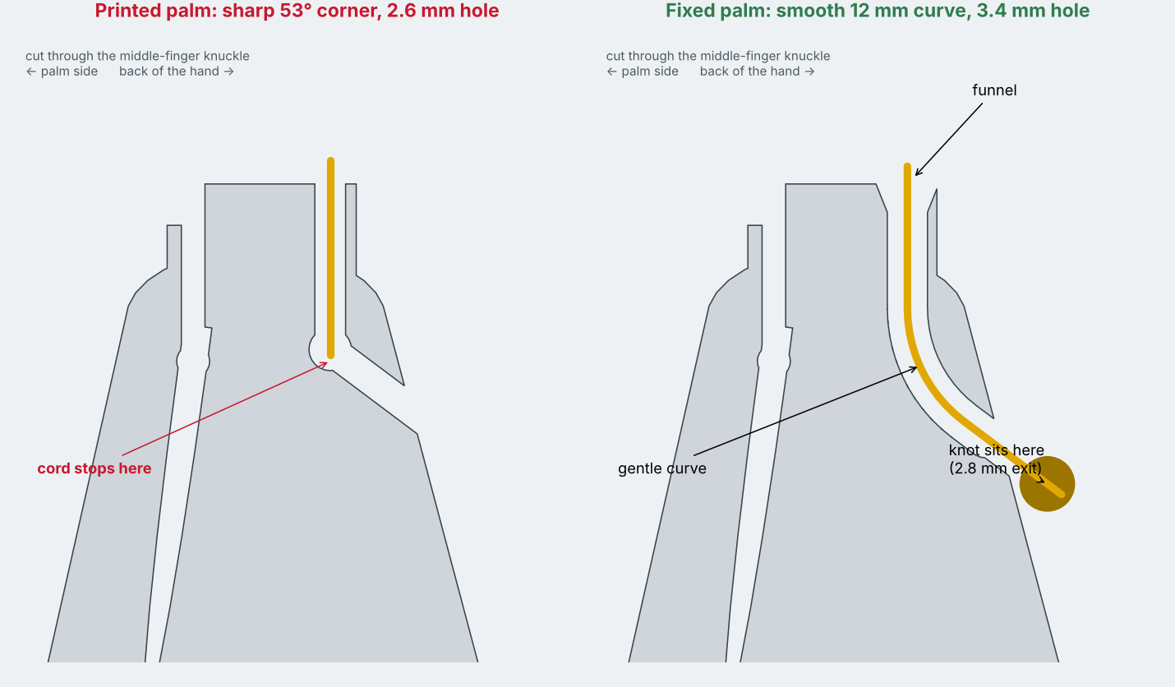
docs/reference/design/elastic_tunnel_fix.png
