antoraja/robo-to-roll/cad/hand.py

"""Five-finger RoboHand on a table stand - printable parts + checks.

Structure (all printed, held together with 1.75 mm filament pins - no screws needed):
  stand   flat base plate: socket for the spine, coin pockets for weight, breadboard tray,
          zip-tie slots for the ESP32
  spine   flat plate (prints flat) carrying the 5 MG90S servos, alternating front / back so
          every string runs straight up to the wrist without touching another spool
  palm    one piece, prints standing on its wrist: knuckle forks for 4 fingers + thumb,
          internal string channels from the wrist to every finger
  fingers the tested finger bones, with human-like lengths per finger (thumb: 2 bones)

Run:   python hand.py            -> collision / stability / routing checks + STLs in stl/hand/
       python hand.py --export X -> also writes a mesh JSON for the 3-D viewer
"""
from __future__ import annotations

import base64
import json
import math
import os
import sys

import numpy as np
import manifold3d as m

HERE = os.path.dirname(os.path.abspath(__file__))
sys.path.insert(0, HERE)
import generate_parts as gp  # noqa: E402
from generate_parts import (C, H, W, ZP, box, joint_distal_end, slab, body_profile,  # noqa: E402
                            channels, skin, phalanx, relief, rod_y, TAPER)

gp.SEG = 40
gp.SKIN_SEG = 40

# ------------------------------------------------------------------ layout
# finger:      bone lengths (mm)         knuckle pin (world x, y, z)   splay (deg)
FINGERS = {
    "index":  dict(L=[45, 30, 25], pin=(0.0, 28.0, 0.0), splay=4.0),
    "middle": dict(L=[49, 33, 26], pin=(0.0, 9.5, 4.0), splay=0.0),
    "ring":   dict(L=[46, 31, 25], pin=(0.0, -9.5, 1.0), splay=-3.0),
    "little": dict(L=[37, 25, 22], pin=(0.0, -28.0, -8.0), splay=-8.0),
}
THUMB = dict(L=[40, 30], pin=(16.0, 44.0, -40.0), direction=(0.35, 0.45, 0.82), curl=(0.75, -0.62, 0.0))
ORDER = ["thumb", "index", "middle", "ring", "little"]

PALM_DROP = 13.0          # palm top sits this far below each knuckle pin
WRIST_Z = -100.0          # flat underside of the palm
SPINE_T = 5.0             # spine plate thickness (x)
SPINE_HW = 31.0           # spine half-width (y)
RIB_D = 9.0               # stiffening ribs stick out this far behind the spine (back side only)
SPINE_TOP = WRIST_Z + 14  # tab that goes up into the palm
SOCKET_TOP = -285.0
SPINE_BOT = -310.0
PLATE_Z = -313.0          # top of the stand's base plate (= table + 5)
PLATE_T = 5.0

# servos: side +1 = spool in front of the spine (palm side), -1 = behind
# every string leaves its spool at "ty" and runs straight up to the wrist
SERVOS = {
    "middle": dict(side=+1, z=-132.0, y=0.0, ty=13.0),
    "index":  dict(side=-1, z=-164.0, y=12.0, ty=25.0),
    "thumb":  dict(side=+1, z=-196.0, y=14.0, ty=27.0),
    "ring":   dict(side=-1, z=-228.0, y=-12.0, ty=-25.0),
    "little": dict(side=+1, z=-260.0, y=-14.0, ty=-27.0),
}
# MG90S
S_BODY_BELOW_TAB = 15.9
S_TAB_T = 2.5
S_CASE_ABOVE_TAB = 4.3
S_LEN, S_WID = 22.8, 12.2
S_TAB_SPAN, S_HOLE_SPACING = 32.3, 27.8
S_SHAFT_FROM_END = 5.9
HORN_GAP = 9.5            # tab top -> spool base (shaft + horn)  [old glued spool]
SHAFT_ABOVE_CASE = 4.0    # MG90S spline top above the case top (community measurement 'shoe height' 4.0)
SHAFT_OFFSET = 0.0        # for robustness checks: real shaft top higher (+) / lower (-) than assumed

STRING_D = 2.4            # palm string channel
PIN_D = 1.9               # filament pin holes
# camera rail on the inside of the palm, low down where the curled fingers never reach
CAM_RAIL_Z = (WRIST_Z, -72.0)                 # rail runs from the palm's flat bottom up to here
CAM_RAIL_X = (30.0, 33.0)                     # dovetail: narrow (+-6) at x=30, wide (+-8) at x=33
CAM_RAIL_HW = (6.0, 8.0)


# elastic: smooth tunnel from each knuckle to an exit on the back of the palm (knot tied outside).
# Prototype 2 jammed at a sharp 53 deg corner in a 2.6 mm hole (flaw B10). Now: 3.4 mm hole,
# a 12 mm-radius curve (6x the cord), a funnel at the top, and a 2.8 mm last bit so the knot can't pull in.
CORD_D = 2.0
ELASTIC_D = 3.4           # tunnel: cord + 1.4 mm (printed holes come out ~0.3 mm small)
EXIT_D, EXIT_LEN = 2.8, 2.0
BEND_R = 12.0             # curve radius = 6 x the cord
ARC_START = -16.0                # local x where the straight drop turns into the curve (column top is at -C = -5.5)
TUNNEL_Z = gp.EXT_Z - 0.3 # a little nearer the pin than the finger's channel: keeps 0.9 mm of back wall
EXIT_DIR = (-0.6, 0.8)    # final direction (local x, z): down and towards the back, as before
ELASTIC = {}              # filled by palm(): per finger the cord path (world points) and the exit


def elastic_path_local():
    """(x, z) points of the cord's centre line in finger-local coordinates, top to past the exit."""
    pts = [(-C + 1.5, TUNNEL_Z), (ARC_START, TUNNEL_Z)]
    ex, ez = EXIT_DIR
    turn = math.atan2(ez, -ex)                       # angle between straight down (-x) and the exit direction
    cx, cz = ARC_START, TUNNEL_Z + BEND_R             # centre of the curve (towards the back)
    for a in np.linspace(0, turn, 12)[1:]:
        pts.append((cx - BEND_R * math.sin(a), cz - BEND_R * math.cos(a)))
    x, z = pts[-1]
    pts.append((x + ex * 40, z + ez * 40))
    return pts


def elastic_tunnel(name, solid):
    """Cut for one finger's elastic: funnel + 3.4 mm tunnel along the smooth path + 2.8 mm exit."""
    W_ = [local_to_world_pt((x, 0.0, z - ZP), name) for x, z in elastic_path_local()]
    # find the exit: walk the whole path (straight drop, curve, straight) until the cord's centre leaves the palm
    exit_, k_exit = None, None
    for k in range(len(W_) - 1):
        a, b = W_[k], W_[k + 1]
        L = float(np.linalg.norm(b - a))
        for s_ in np.arange(0, L, 0.1):
            x = a + (b - a) * (s_ / L)
            if k >= 1 and (m.Manifold.sphere(0.15, 8).translate(tuple(x)) ^ solid).volume() < 1e-6:
                exit_, k_exit = x, k
                break
        if exit_ is not None:
            break
    assert exit_ is not None
    d = (W_[k_exit + 1] - W_[k_exit]) / np.linalg.norm(W_[k_exit + 1] - W_[k_exit])
    seg_end = exit_ - d * EXIT_LEN
    pts = W_[:k_exit + 1] + [seg_end]
    cut = None
    for p0, p1 in zip(pts[:-1], pts[1:]):
        r = rod(p0, p1, ELASTIC_D, 24) + m.Manifold.sphere(ELASTIC_D / 2, 24).translate(tuple(p1))
        cut = r if cut is None else cut + r
    cut += rod(seg_end - d * 0.5, exit_ + d * 4, EXIT_D, 24)
    # funnel where the cord enters from the finger (top of the knuckle column)
    fa = finger_basis(name)[:, 2]
    top = local_to_world_pt((-C + 0.6, 0.0, TUNNEL_Z - ZP), name)
    cut += m.Manifold.cylinder(3.0, ELASTIC_D / 2, ELASTIC_D / 2 + 1.2, 24).transform(
        np.column_stack([np.cross(finger_basis(name)[:, 1], fa), finger_basis(name)[:, 1], fa, top - fa * 3.0]).tolist())
    ELASTIC[name] = dict(path=pts, exit=exit_, dir=d, top=W_[0], cut=cut)
    return cut


# finger pins go in FROM ABOVE: a slot in each palm prong (flaw B11: the forks are only 1.1-1.6 mm
# apart, so a 17 mm pin can't be pushed in from the side, and sideways holes print too small).
# Pin through the finger's tab first, lower the finger into the fork (pin ends slide down the slots),
# nudge it towards the palm side: the pin drops into the seat at the exact pivot. Elastic keeps it there.
PIN_SEAT_D = 2.15         # seat at the pivot (pin 1.75 mm)
PIN_SLOT_W = 2.0          # slot the pin slides down
PIN_SLOT_Z = 2.4          # slot is this far towards the back of the hand from the seat
PIN_STEP_X = 0.9          # the seat is ~1 mm deeper than the slot bottom: the pin can't lift straight out


def pin_slot_profile():
    J = gp.circ(PIN_SEAT_D / 2, 0.0, 0.0)
    J += m.CrossSection.batch_hull([gp.circ(PIN_SLOT_W / 2, PIN_STEP_X, 0.0), gp.circ(PIN_SLOT_W / 2, PIN_STEP_X, PIN_SLOT_Z)])
    J += m.CrossSection.batch_hull([gp.circ(PIN_SLOT_W / 2, PIN_STEP_X, PIN_SLOT_Z), gp.circ(PIN_SLOT_W / 2, 9.0, PIN_SLOT_Z)])
    return J


def pin_insert_path():
    """Pin centre positions (local x along the finger, z towards the back), from above down into the seat."""
    return [(9.0, PIN_SLOT_Z), (PIN_STEP_X, PIN_SLOT_Z), (PIN_STEP_X, 0.0), (0.0, 0.0)]


def cam_rail():
    z0, z1 = CAM_RAIL_Z
    x0, x1 = CAM_RAIL_X
    ped = box(22.0, x0 + 0.01, -9.0, 9.0, z0, z1)
    dove = m.Manifold.batch_hull([box(x0, x0 + 0.01, -CAM_RAIL_HW[0], CAM_RAIL_HW[0], z0, z1),
                                  box(x1 - 0.01, x1, -CAM_RAIL_HW[1], CAM_RAIL_HW[1], z0, z1)])
    return ped + dove


# ----------------------------------------------------------------- helpers
def basis(direction, curl):
    d = np.array(direction, float); d /= np.linalg.norm(d)
    c = np.array(curl, float); c -= d * (c @ d); c /= np.linalg.norm(c)
    return np.column_stack([c, np.cross(d, c), d])


def finger_basis(name):
    if name == "thumb":
        return basis(THUMB["direction"], THUMB["curl"])
    a = math.radians(FINGERS[name]["splay"])
    return basis((0.0, math.sin(a), math.cos(a)), (1.0, 0.0, 0.0))


def finger_pin(name):
    return np.array(THUMB["pin"] if name == "thumb" else FINGERS[name]["pin"], float)


def finger_L(name):
    return THUMB["L"] if name == "thumb" else FINGERS[name]["L"]


def local_to_world_pt(p_local, name):
    """finger-local point (pivot at origin, i.e. after the -ZP shift) -> world."""
    x, y, z = p_local
    v = np.array([-z, y, x])
    return finger_basis(name) @ v + finger_pin(name)


def place(part_local, name):
    p = part_local.rotate((0.0, -90.0, 0.0))
    M = np.eye(4); M[:3, :3] = finger_basis(name); M[:3, 3] = finger_pin(name)
    return p.transform(M[:3, :].tolist())


def rod(p0, p1, d, seg=24):
    """Cylinder between two world points."""
    p0, p1 = np.array(p0, float), np.array(p1, float)
    v = p1 - p0
    L = float(np.linalg.norm(v))
    z = v / L
    a = np.array([1.0, 0, 0]) if abs(z[0]) < 0.9 else np.array([0, 1.0, 0])
    x = np.cross(a, z); x /= np.linalg.norm(x)
    y = np.cross(z, x)
    M = np.eye(4); M[:3, 0], M[:3, 1], M[:3, 2], M[:3, 3] = x, y, z, p0
    return m.Manifold.cylinder(L, d / 2, d / 2, seg).transform(M[:3, :].tolist())


def blob(c, s, seg=32):
    return m.Manifold.sphere(1, seg).scale(tuple(s)).translate(tuple(c))


# ----------------------------------------------------------------- servos
def spool_x(side):
    tab_top = side * (SPINE_T / 2 + S_TAB_T)
    return tab_top + side * HORN_GAP          # spool base (glued to horn)


def shaft_top_x(side):
    return side * (SPINE_T / 2 + S_TAB_T + S_CASE_ABOVE_TAB + SHAFT_ABOVE_CASE + SHAFT_OFFSET)


def groove_x(side):
    """x of the string groove centre on the horn-free spool (v3)."""
    return shaft_top_x(side) + side * (gp.V3_BODY_Z + gp.SPOOL_FLANGE_T + gp.SPOOL_CORE_W / 2)


GROOVE_R = gp.V3_GROOVE_R   # bottom of the string groove on the horn-free spool


def spool_core_x(side):
    return spool_x(side) + side * (gp.SPOOL_FLANGE_T + gp.SPOOL_CORE_W / 2)


def servo_geom(name):
    s = SERVOS[name]; side, y, z = s["side"], s["y"], s["z"]
    face = side * SPINE_T / 2
    # body: shaft end at the top, body hangs downward
    z_top, z_bot = z + S_SHAFT_FROM_END, z + S_SHAFT_FROM_END - S_LEN
    x_back = face - side * S_BODY_BELOW_TAB
    x_front = face + side * (S_TAB_T + S_CASE_ABOVE_TAB)
    body = box(min(x_back, x_front), max(x_back, x_front), y - S_WID / 2, y + S_WID / 2, z_bot, z_top)
    zc = (z_top + z_bot) / 2
    tabs = box(min(face, face + side * S_TAB_T), max(face, face + side * S_TAB_T), y - S_WID / 2, y + S_WID / 2,
               zc - S_TAB_SPAN / 2, zc + S_TAB_SPAN / 2)
    sp = gp.spool_v3().rotate((0.0, 90.0 * side, 0.0)).translate((shaft_top_x(side), y, z))   # horn-free spool on the spline
    holes = [(y, zc - S_HOLE_SPACING / 2), (y, zc + S_HOLE_SPACING / 2)]
    cut = (y, z_bot - 0.2, z_top + 0.2)
    return body + tabs, sp, holes, cut


def string_path(name):
    """World points of the flexor string from the spool to the knuckle column bottom."""
    s = SERVOS[name]
    xs = spool_core_x(s["side"])
    # where the string really leaves the (horn-free, v3) spool: groove centre, at the groove radius
    tangent = (groove_x(s["side"]), s["y"] + (s["ty"] - s["y"]) * GROOVE_R / gp.SPOOL_R, s["z"])
    wrist = (xs, s["ty"], WRIST_Z - 0.5)
    col_len = PALM_DROP + 2
    knuckle = local_to_world_pt((-C - col_len, 0.0, gp.FLEX_Z - ZP), name)
    return [np.array(tangent), np.array(wrist), knuckle]


# ------------------------------------------------------------------ parts
def knuckle_local():
    col_len = PALM_DROP + 2
    col = slab(body_profile(-C - col_len, -C, chamfer_start=False), -W / 2, W / 2)
    col += joint_distal_end(0.0)
    col -= channels(-C - col_len - 5, 1.0)
    col -= relief(-C, -1)
    col ^= skin(-C - col_len - 8, 0.0, 1.03, TAPER[0]) + box(-C - col_len - 1, -C - col_len + 3, -W, W, -H, H)
    return col.translate((0, 0, -ZP))


def palm():
    blobs = []
    for name, f in FINGERS.items():
        top = finger_pin(name) + finger_basis(name) @ np.array([0, 0, -PALM_DROP - 4])
        blobs.append(blob(top + np.array([1.5, 0, 0]), (11, 10, 6)))
    blobs.append(blob((2.0, 0.0, -55.0), (13, 34, 14)))
    blobs.append(blob((4.0, 30.0, -64.0), (12, 11, 16)))
    # wrist block: wide enough to take all five strings coming up from the spools
    for sx in (-23.0, 23.0):
        for sy in (-31.0, 31.0):
            blobs.append(m.Manifold.cylinder(14, 6, 6, 32).translate((sx, sy, WRIST_Z)))   # vertical walls at the bed
    p = m.Manifold.batch_hull(blobs)
    p ^= box(-60, 60, -60, 60, WRIST_Z, 200)                       # flat bottom (prints on it)
    for name in ORDER:
        if name != "thumb":                          # the thumb's fork goes on once, after its clearance cut
            p += place(knuckle_local(), name)
    Rt = finger_basis("thumb")
    foot = finger_pin("thumb") + Rt @ np.array([0, 0, -PALM_DROP - 2])
    p += m.Manifold.batch_hull([blob(foot, (8, 8, 8), 24), blob((4.0, 30.0, -60.0), (9, 9, 9), 24)])
    # clearance for the thumb: cut away whatever the thumb's lower bone sweeps through when its
    # base joint bends to the limit (+3 deg margin), then put the thumb's knuckle fork back
    prox = finger_bones("thumb")[0]
    sweep = None
    for ang in (40, 55, 65, 72, 78, 83, 88):
        b = posed("thumb", ang, [prox, prox])[0]
        sweep = b if sweep is None else sweep + b
    p -= sweep
    p += place(knuckle_local(), "thumb")
    p += cam_rail()                                   # added BEFORE any hole is cut
    for name in ORDER:                                # pin slots in the knuckle-fork prongs
        for y0, y1 in ((gp.SLOT_HALF - 0.2, gp.W / 2 + 0.3), (-gp.W / 2 - 0.3, -gp.SLOT_HALF + 0.2)):   # each prong only
            p -= place(gp.slab(pin_slot_profile(), y0, y1), name)
    # elastic tunnels, exits found on the palm surface BEFORE any hole is cut
    body = p
    cleats = [elastic_tunnel(name, body) for name in ORDER]
    # re-open the string channel inside every knuckle column: the palm hull above filled it back in
    # (prototype 1 printed with ~6 mm solid plugs in all 10 holes); a rounded chamber at the bottom
    # lets the string turn into the palm channel.
    col_len = PALM_DROP + 2
    for name in ORDER:
        k_x = -C - col_len
        cut = gp.rod_x(gp.CHANNEL_D, 0, gp.FLEX_Z, k_x, -C + 1.0)
        cut += m.Manifold.sphere(gp.CHANNEL_D / 2 + 0.4, 24).translate((k_x, 0, gp.FLEX_Z))
        p -= place(cut.translate((0, 0, -ZP)), name)
    # string channels (straight, smooth)
    for name in ORDER:
        _, w, k = string_path(name)
        p -= rod(w - np.array([0, 0, 2]), k + (k - w) / np.linalg.norm(k - w) * 3, STRING_D)
    for c in cleats:
        p -= c
    # spine socket + pin holes
    p -= box(-SPINE_T / 2 - 0.2, SPINE_T / 2 + 0.2, -15.2, 15.2, WRIST_Z - 1, SPINE_TOP + 0.3)
    for y in (-5.0, 5.0):
        p -= rod((-40, y, WRIST_Z + 7), (40, y, WRIST_Z + 7), PIN_D)
    return p


def spine():
    s = box(-SPINE_T / 2, SPINE_T / 2, -SPINE_HW, SPINE_HW, SPINE_BOT, WRIST_Z)
    s += box(-SPINE_T / 2, SPINE_T / 2, -15.0, 15.0, WRIST_Z - 0.1, SPINE_TOP)     # palm tab
    for sy in (-SPINE_HW, SPINE_HW - 3):                                           # edge ribs, back side only:
        s += box(-RIB_D, SPINE_T / 2, sy, sy + 3, SPINE_BOT, WRIST_Z)              # front face stays flat for printing
    for name in ORDER:
        _, _, holes, (y, z0, z1) = servo_geom(name)
        s -= box(-10, 10, y - S_WID / 2 - 0.2, y + S_WID / 2 + 0.2, z0, z1)
        for (hy, hz) in holes:
            s -= rod((-10, hy, hz), (10, hy, hz), 1.8)
    for y in (-5.0, 5.0):                                                          # palm pins
        s -= rod((-10, y, WRIST_Z + 7), (10, y, WRIST_Z + 7), PIN_D)
    for y in (-20.0, 20.0):                                                        # stand pins
        s -= rod((-10, y, SPINE_BOT + 11), (10, y, SPINE_BOT + 11), PIN_D)
    # FRONT marker: a 5 mm dot pressed into the front (palm-side) face just below the wrist.
    # Front servos (middle, thumb, little) mount with their tabs and spools on this side.
    s -= rod((SPINE_T / 2 - 1.2, 0.0, WRIST_Z - 12), (SPINE_T / 2 + 1, 0.0, WRIST_Z - 12), 5.0)
    return s


def stand():
    hx, hy, r = 80.0, 70.0, 10.0
    corners = [m.Manifold.cylinder(PLATE_T, r, r, 48).translate((sx * (hx - r), sy * (hy - r), PLATE_Z - PLATE_T))
               for sx in (-1, 1) for sy in (-1, 1)]
    plate = m.Manifold.batch_hull(corners)
    sock = box(-12.0, 12.0, -38.0, 38.0, PLATE_Z - 0.1, SOCKET_TOP)
    sock += m.Manifold.batch_hull([box(-12, 12, -38, 38, PLATE_Z - 0.1, PLATE_Z + 0.1),
                                   box(-26, 26, -46, 46, PLATE_Z - 0.1, PLATE_Z + 0.1),
                                   box(-12, 12, -38, 38, PLATE_Z + 12, PLATE_Z + 12.1)])   # gusset flare
    st = plate + sock
    st -= box(-SPINE_T / 2 - 0.2, SPINE_T / 2 + 0.2, -SPINE_HW - 0.2, SPINE_HW + 0.2, SPINE_BOT, SOCKET_TOP + 1)
    st -= box(-RIB_D - 0.2, SPINE_T / 2 + 0.2, -SPINE_HW - 0.2, -SPINE_HW + 3.2, SPINE_BOT, SOCKET_TOP + 1)
    st -= box(-RIB_D - 0.2, SPINE_T / 2 + 0.2, SPINE_HW - 3.2, SPINE_HW + 0.2, SPINE_BOT, SOCKET_TOP + 1)
    for y in (-20.0, 20.0):
        st -= rod((-30, y, SPINE_BOT + 11), (30, y, SPINE_BOT + 11), PIN_D)
    # coin pockets (weight) at the corners: 26 mm coins / washers, 3.5 mm deep
    for sx in (-1, 1):
        for sy in (-1, 1):
            st -= m.Manifold.cylinder(4, 13.5, 13.5, 48).translate((sx * 62, sy * 50, PLATE_Z - 3.5))
    # breadboard tray (400-point, 84 x 56 mm) behind the arm
    st -= box(-78.0, -22.0, -42.5, 42.5, PLATE_Z - 1.5, PLATE_Z + 1)
    # ESP32 zip-tie slots in front of the arm
    for x in (32.0, 64.0):
        for y in (-22.0, 22.0):
            st -= box(x - 2, x + 2, y - 1.5, y + 1.5, PLATE_Z - PLATE_T - 1, PLATE_Z + 1)
    return st


def finger_bones(name):
    L = finger_L(name)
    if len(L) == 3:
        return [phalanx(L[0]), phalanx(L[1], which="mid"), phalanx(L[2], distal=True)]
    return [phalanx(L[0]), phalanx(L[1], distal=True)]


def posed(name, curl_deg, bones=None):
    bones = bones or finger_bones(name)
    T = np.eye(4); out = []
    for b, length in zip(bones, finger_L(name)):
        a = math.radians(curl_deg)
        Ry = np.array([[math.cos(a), 0, math.sin(a), 0], [0, 1, 0, 0], [-math.sin(a), 0, math.cos(a), 0], [0, 0, 0, 1]])
        T = T @ Ry
        out.append(place(b.translate((0, 0, -ZP)).transform(T[:3, :].tolist()), name))
        S = np.eye(4); S[0, 3] = length; T = T @ S
    return out


# ------------------------------------------------------------------ checks
def checks(P, SP, ST, bones):
    print("1) Collisions")
    servos = {n: servo_geom(n) for n in ORDER}
    worst = 0.0
    for n in ORDER:
        body, sp, _, _ = servos[n]
        worst = max(worst, (body ^ ST).volume(), (sp ^ ST).volume(), (sp ^ SP).volume(), (sp ^ P).volume(), (body ^ P).volume())
        for n2 in ORDER:
            if n2 != n:
                worst = max(worst, (sp ^ servos[n2][0]).volume(), (sp ^ servos[n2][1]).volume(), (body ^ servos[n2][0]).volume())
    print(f"   servos / spools vs each other, spine, palm, stand: worst overlap {worst:.2f} mm3")
    tubes = {n: rod(string_path(n)[0], string_path(n)[1], 0.6) for n in ORDER}
    hit = max((tubes[n] ^ (servos[n2][1] + servos[n2][0])).volume() for n in ORDER for n2 in ORDER if n2 != n)
    hit_spine = max((tubes[n] ^ SP).volume() for n in ORDER)
    print(f"   strings (spool -> wrist) touching another servo/spool: {hit:.2f} mm3, touching spine: {hit_spine:.2f} mm3")
    for curl in (0, 45, 85):
        palm_hit, pair = 0.0, 0.0
        ps = {n: posed(n, curl if n != "thumb" else 0, bones[n]) for n in ORDER}
        for n in ORDER:
            for i, b in enumerate(ps[n]):
                tgt = P - place(knuckle_local(), n) if i == 0 else P
                palm_hit = max(palm_hit, (b ^ tgt).volume())
        for a, b in zip(ORDER[1:], ORDER[2:]):
            pair = max(pair, max((x ^ y).volume() for x in ps[a] for y in ps[b]))
        print(f"   fingers at {curl:2d} deg/joint: finger-palm {palm_hit:.1f} mm3, finger-finger {pair:.1f} mm3")
    for c in (45, 85):
        th = posed("thumb", c, bones["thumb"])
        print(f"   thumb at {c} deg vs palm: {sum(((b ^ (P - place(knuckle_local(), 'thumb'))) if i == 0 else (b ^ P)).volume() for i, b in enumerate(th)):.1f} mm3")

    print("2) String routing through the palm")
    for n in ORDER:
        t, w, k = string_path(n)
        p0 = w + (k - w) / np.linalg.norm(k - w) * 2
        p1 = k - (k - w) / np.linalg.norm(k - w) * 2
        wall = rod(p0, p1, STRING_D + 2.4) - rod(p0, p1, STRING_D + 0.2)    # 1.2 mm wall around the channel
        outside = (wall - P).volume() / wall.volume() * 100
        d_in = (k - w) / np.linalg.norm(k - w)
        axis = finger_basis(n)[:, 2]
        bend_wrist = math.degrees(math.acos(np.clip(d_in @ np.array([0, 0, 1.0]), -1, 1)))
        bend_knuckle = math.degrees(math.acos(np.clip(d_in @ axis, -1, 1)))
        extra = math.exp(0.25 * math.radians(bend_wrist + bend_knuckle))
        print(f"   {n:<7} channel wall (1.2 mm) missing: {outside:4.1f} %  bends {bend_wrist:4.1f}° at wrist + "
              f"{bend_knuckle:4.1f}° at knuckle -> friction x{extra:.2f}")

    print("3) Stability on the table (PLA ~45 % effective density, servos 13.4 g)")
    rho = 1.24e-3 * 0.45
    items = [(P, rho), (SP, rho), (ST, rho)]
    for n in ORDER:
        for b in posed(n, 85 if n != "thumb" else 60, bones[n]):
            items.append((b, rho))
    mass, mom = 0.0, np.zeros(3)
    for part, r in items:
        v = part.volume(); c = centroid(part)
        mass += v * r; mom += v * r * c
    for n in ORDER:
        body, sp, _, _ = servo_geom(n)
        mass += 13.4; mom += 13.4 * centroid(body)
    com = mom / mass
    h = com[2] - (PLATE_Z - PLATE_T)
    edges = {"front": 80 - com[0], "back": 80 + com[0], "side": 70 - abs(com[1])}
    tip = {k: math.degrees(math.atan2(v, h)) for k, v in edges.items()}
    print(f"   total ~{mass:.0f} g, centre of mass {h:.0f} mm above the table, {com[0]:+.0f} mm forward")
    print("   tips over only if tilted: " + ", ".join(f"{k} {v:.0f}°" for k, v in tip.items()))
    top = 430.0
    push = mass * min(edges.values()) / top
    coins = 4 * 7.5                                     # four 26 mm coins / washers (~7.5 g each)
    push_c = (mass * min(edges.values()) + coins * 62) / top
    print(f"   sideways push at the fingertips needed to tip it: ~{push:.0f} g-force; with 4 coins in the pockets ~{push_c:.0f} g-force")


def seg_dist(p1, q1, p2, q2):
    """Shortest distance between two 3-D segments."""
    d1, d2, r = q1 - p1, q2 - p2, p1 - p2
    a, e, f = d1 @ d1, d2 @ d2, d2 @ r
    c, b = d1 @ r, d1 @ d2
    den = a * e - b * b
    s = np.clip((b * f - c * e) / den, 0, 1) if den > 1e-9 else 0.0
    t = np.clip((b * s + f) / e, 0, 1)
    s = np.clip((b * t - c) / a, 0, 1)
    return float(np.linalg.norm((p1 + d1 * s) - (p2 + d2 * t)))


def elastic_checks(P):
    """The REAL cord, not an ideal ball (flaw B10): 2.0 mm rubber cord, checked as 2.3 mm for holes printing small."""
    print("   elastic tunnels (2 mm cord, checked as 2.3 mm for print shrink):")
    real = CORD_D + 0.3
    bad = []
    for n in ORDER:
        e = ELASTIC[n]
        pts, ex, d = e["path"], e["exit"], e["dir"]
        chain = None
        for p0, p1 in zip(pts[:-1] + [pts[-1]], pts[1:] + [ex + d * 2]):
            r = rod(p0, p1, real, 16)
            chain = r if chain is None else chain + r
        free = (chain ^ P).volume()
        # sharpest change of direction between neighbouring pieces of the path (curve = many small steps)
        dirs = [(b - a) / np.linalg.norm(b - a) for a, b in zip(pts[:-1], pts[1:])]
        step = max(math.degrees(math.acos(np.clip(np.dot(u, v), -1, 1))) for u, v in zip(dirs[:-1], dirs[1:]))
        # wall: thin rings square to the path, every 1 mm. From 4 mm below the top (the funnel is open on
        # purpose) to 5 mm before the exit (an angled hole always thins where it meets the surface),
        # the 0.8 mm ring of plastic round the 3.4 mm tunnel must be complete.
        L_exit = sum(np.linalg.norm(b - a) for a, b in zip(pts[:-1], pts[1:]))
        worst_ring, acc = 0.0, 0.0
        for a, b in zip(pts[:-1], pts[1:]):
            u = (b - a) / np.linalg.norm(b - a)
            L = float(np.linalg.norm(b - a))
            for s_ in np.arange(0, L, 1.0):
                if 4.0 <= acc + s_ <= L_exit - 5.0:
                    c = a + u * s_
                    ann = rod(c - u * 0.2, c + u * 0.2, ELASTIC_D + 1.6, 24) - rod(c - u * 0.3, c + u * 0.3, ELASTIC_D + 0.02, 24)
                    worst_ring = max(worst_ring, (ann - P).volume() / ann.volume() * 100)
            acc += L
        wall = worst_ring
        # knot: a 4 mm knot sitting at the exit can't be pulled into the 2.8 mm end
        knot = (m.Manifold.sphere(2.0, 16).translate(tuple(ex - d * 0.8)) ^ P).volume()
        ok_ = free < 0.05 and step < 6 and BEND_R >= 5 * CORD_D and wall < 5.0 and knot > 1.0
        print(f"     {n:<7} cord path free {free:.2f} mm3, curve radius {BEND_R:.0f} mm ({BEND_R / CORD_D:.0f}x cord), "
              f"largest kink {step:.1f} deg (old: 53), 0.8 mm wall {100 - wall:.0f} % complete, knot can't enter ({knot:.1f}) -> {'OK' if ok_ else 'FAIL'}")
        if not ok_:
            bad.append(n)
    walls = 0.0
    for n in ORDER:
        _, w, k = string_path(n)
        ring_ = rod(w - np.array([0, 0, 2]), k, STRING_D + 2.4, 16) - rod(w - np.array([0, 0, 2]), k, STRING_D, 16)
        walls += sum((ELASTIC[e]["cut"] ^ ring_).volume() for e in ORDER)
    print(f"     string channel walls touched by the elastic tunnels: {walls:.2f} mm3")
    assert not bad and walls < 1.0, f"elastic path problems: {bad}, walls {walls:.2f}"


SERVO_LEAD = 200.0        # MG90S lead length (mm): the ordered 6-pack has 20 cm leads


def extra_checks(P):
    """Things a builder would trip over: channels crossing, elastic exits, pins, cable reach."""
    print("5) Assembly details")
    col_len = PALM_DROP + 2
    strings, elastics = {}, {}
    for n in ORDER:
        _, w, k = string_path(n)
        strings[n] = (w, k)
        if n not in ELASTIC:
            palm()
        elastics[n] = (ELASTIC[n]["path"][1], ELASTIC[n]["exit"])
    worst = (99.0, "")
    names = list(ORDER)
    for i, a in enumerate(names):
        for b in names[i + 1:]:
            d = seg_dist(*strings[a], *strings[b]) - STRING_D
            worst = min(worst, (d, f"string {a} / string {b}"))
        for b in names:
            d = seg_dist(*strings[a], *elastics[b]) - (STRING_D + ELASTIC_D) / 2
            worst = min(worst, (d, f"string {a} / elastic {b}"))
            if a < b:
                d2 = seg_dist(*elastics[a], *elastics[b]) - ELASTIC_D
                worst = min(worst, (d2, f"elastic {a} / elastic {b}"))
    print(f"   closest pair of channels in the palm: {worst[1]} with {worst[0]:.1f} mm of plastic between them")
    pins = [(np.array([-40.0, y, WRIST_Z + 7]), np.array([40.0, y, WRIST_Z + 7])) for y in (-5.0, 5.0)]
    near_pin = min(seg_dist(*p, *strings[n]) - (PIN_D + STRING_D) / 2 for p in pins for n in ORDER)
    print(f"   palm pin holes vs string channels: {near_pin:.1f} mm apart")
    # string: slide a ball a bit thinner than the string along the whole path. Any plastic in the way = a plug.
    def blocked(pts, d):
        worst = 0.0
        for a, b in zip(pts[:-1], pts[1:]):
            L = float(np.linalg.norm(b - a))
            for t in np.linspace(0, 1, max(2, int(L / 0.5) + 1)):
                s = m.Manifold.sphere(d / 2, 12).translate(tuple(a + (b - a) * t))
                worst = max(worst, (s ^ P).volume() / s.volume())
        return worst * 100
    bad = []
    for n in ORDER:
        _, w, k = string_path(n)
        top_s = local_to_world_pt((-C + 0.5, 0.0, gp.FLEX_Z - ZP), n)
        bs = blocked([top_s, k, w], 1.2)
        print(f"   {n:<7} string path open end to end: {'OK' if bs < 1 else f'BLOCKED {bs:.0f} %'}")
        if bs >= 1:
            bad.append(n)
    assert not bad, f"string channels blocked in: {bad}"
    elastic_checks(P)
    slot = box(-SPINE_T / 2 - 0.2, SPINE_T / 2 + 0.2, -15.2, 15.2, WRIST_Z - 1, SPINE_TOP + 0.3)
    hit = sum((rod(*elastics[n], ELASTIC_D) ^ slot).volume() + (rod(*strings[n], STRING_D) ^ slot).volume() for n in ORDER)
    print(f"   channels cutting into the spine slot: {hit:.1f} mm3")
    print("   servo lead reach (MG90S lead 20 cm) to the breadboard behind the arm:")
    bb = np.array([-50.0, 0.0, PLATE_Z + 9])
    for n in ORDER:
        body, _, _, _ = servo_geom(n)
        lo, hi = body.bounding_box()[:3], body.bounding_box()[3:]
        exit_pt = np.array([(lo[0] + hi[0]) / 2, SERVOS[n]["y"], lo[2]])   # lead leaves the bottom end of the case
        route = abs(exit_pt[2] - (PLATE_Z + 2)) + abs(exit_pt[0] - bb[0]) + abs(exit_pt[1] - bb[1]) + 30  # +30 slack
        ok = "OK" if route <= SERVO_LEAD - 20 else "short - bridged by the 20 cm male-male jumpers to the breadboard"
        print(f"      {n:<7} needs ~{route:3.0f} mm  {ok}")


def centroid(part):
    mesh = part.to_mesh()
    v = np.asarray(mesh.vert_properties)[:, :3]; f = np.asarray(mesh.tri_verts)
    a, b, c = v[f[:, 0]], v[f[:, 1]], v[f[:, 2]]
    vol = np.einsum("ij,ij->i", a, np.cross(b, c)) / 6
    return ((a + b + c) / 4 * vol[:, None]).sum(0) / vol.sum()


def save(part, name, rot=(0, 0, 0)):
    import trimesh
    p = part.rotate(rot)
    lo = np.array(p.bounding_box()[:3]); p = p.translate(tuple(-lo))
    mesh = p.to_mesh()
    t = trimesh.Trimesh(np.asarray(mesh.vert_properties)[:, :3], np.asarray(mesh.tri_verts))
    assert t.is_watertight, name
    out = os.path.join(HERE, "stl", "hand"); os.makedirs(out, exist_ok=True)
    t.export(os.path.join(out, name))
    e = t.extents
    print(f"   {name:<26} {e[0]:6.1f} x {e[1]:6.1f} x {e[2]:6.1f} mm  {t.volume / 1000 * 1.24 * 0.45:5.0f} g")


def write_stls(P, SP, ST, bones):
    print("4) Printable parts (stl/hand/), PLA estimate")
    save(P, "palm.stl")                              # stands on its flat wrist
    save(SP, "spine.stl", (0, 90, 0))                # lies flat
    save(ST, "stand.stl")
    save(gp.spool_v3(), "servo_spool_x5.stl", (180, 0, 0))      # no horn: presses on the spline, flange on the bed
    save(gp.spline_fit_test(), "spline_fit_test.stl")
    for n in ORDER:
        names = ["proximal", "middle", "distal"] if len(finger_L(n)) == 3 else ["proximal", "distal"]
        for b, part in zip(bones[n], names):
            save(b, f"{n}_{part}.stl", (180, 0, 0))   # on its flat back


def export(path, P, SP, ST, bones):
    def enc(p):
        mm = p.to_mesh()
        v = np.asarray(mm.vert_properties)[:, :3].astype(np.float32)
        f = np.asarray(mm.tri_verts).astype(np.uint32)
        return {"v": base64.b64encode(v.tobytes()).decode(), "i": base64.b64encode(f.tobytes()).decode()}
    data = {"palm": enc(P), "spine": enc(SP), "stand": enc(ST), "fingers": {}, "servos": [],
            "params": dict(FLEX_Z=gp.FLEX_Z, ZP=ZP, C=C, spoolR=gp.SPOOL_R, colLen=PALM_DROP + 2)}
    for n in ORDER:
        data["fingers"][n] = dict(L=finger_L(n), pin=finger_pin(n).tolist(), R=finger_basis(n).T.flatten().tolist(),
                                  bones=[enc(b.translate((0, 0, -ZP))) for b in bones[n]])
        body, sp, _, _ = servo_geom(n)
        s = SERVOS[n]
        t, w, _ = string_path(n)
        data["servos"].append(dict(finger=n, body=enc(body), spool=enc(sp), side=s["side"],
                                   centre=[spool_core_x(s["side"]), s["y"], s["z"]],
                                   path=[t.tolist(), w.tolist()]))
    with open(path, "w") as fh:
        json.dump(data, fh)
    print("exported", path, os.path.getsize(path) // 1024, "KB")


if __name__ == "__main__":
    P, SP, ST = palm(), spine(), stand()
    bones = {n: finger_bones(n) for n in ORDER}
    checks(P, SP, ST, bones)
    extra_checks(P)
    if "--checks-only" in sys.argv:
        sys.exit(0)
    write_stls(P, SP, ST, bones)
    if "--export" in sys.argv:
        export(sys.argv[sys.argv.index("--export") + 1], P, SP, ST, bones)
