antoraja/robo-to-roll/(commit log)

2026-11-01 RoboHand one-finger starter: guides, printable parts, ESP32 firmware
    Claude-Session: https://claude.ai/code/session_016UHVJgW2w5zeEXY4wxHoiJ
    [finger_base.stl, finger_distal.stl, finger_middle.stl, finger_proximal.stl, servo_spool.stl]
2026-11-01 Simulate the finger in MuJoCo and fix the flaws it found
    The physics check (sim/finger_sim.py) showed the first design would not work
    well: joints snapped closed one at a time, the finger fell closed palm-down,
    the spool could not pull enough string, and the string got pinched at full
    curl. Fixes in the CAD: per-joint elastic with lock pins wrapping a rounded
    knuckle groove (constant leverage), 2 mm elastic, 13 mm spool, string relief
    grooves. Docs and STLs updated; results in sim/README.md.
    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
    [finger_base.stl, finger_distal.stl, finger_middle.stl, finger_proximal.stl, servo_spool.stl]
2026-11-01 Give the finger a finger shape: oval, tapered bones with a domed tip
    Bones are trimmed to a smooth tapered oval skin (hull of ellipsoids at each
    pin) with a flat back strip so they still print support-free. Joint
    mechanics unchanged; a new 3-D check rotates the real bones through their
    range (only contact is the intended -3 deg stop). Simulation re-run with the
    lighter bones: still passes. Docs explain the shape and cheap finishing
    options (hot-glue pads, inner tube, glove skin).
    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
    [finger_base.stl, finger_distal.stl, finger_middle.stl, finger_proximal.stl]
2026-11-01 Make spool print without overhang; add fit-test-first print order
    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
    [servo_spool.stl]
2026-11-01 Add five-finger hand layout concept
    cad/hand_concept.py places four fingers (human-like bone lengths) and a
    two-joint thumb on a rounded palm with knuckle forks, and puts five MG90S
    servos with spools in a forearm. It checks for collisions (all fingers
    0-85 deg, thumb vs palm/fingers, servos vs forearm wall), estimates PLA use
    (~195 g), and exports meshes for the interactive viewer.
    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
2026-11-01 Printable five-finger hand on a table stand
    Replace the layout concept with printable parts (cad/hand.py):
    - stand: base plate with spine socket, coin pockets, breadboard tray and
    ESP32 zip-tie slots
    - spine: flat servo plate, servos alternating front/back so every string
    runs straight to the wrist without touching another spool
    - palm: one piece with internal string channels and elastic anchors
    - per-finger bone STLs (human-like lengths, 2-joint thumb)
    All joints use filament pins. Checks: collisions, string clearance and
    channel walls, tipping stability; longest/shortest fingers re-simulated.
    Firmware gains a five-finger config and gesture buttons. New guide 05.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
    [index_distal.stl, index_middle.stl, index_proximal.stl, little_distal.stl, little_middle.stl, little_proximal.stl, middle_distal.stl, middle_middle.stl]
2026-11-01 Make the five-finger hand the main build path; add rolling-stage roadmap
    Skip the separate one-finger rig: the fit test uses the index finger's bones
    (reused in the hand) and the electronics test uses one servo on the index
    pin. Shopping list now covers the full hand, firmware defaults to 5 fingers,
    and the roadmap adds wrist/thumb-base, fingertip sensors and the rolling
    station.
    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
    [finger_control.ino]
2026-11-01 Add whole-arm 3D files, print plates, amazon.de list and video renderer
    - cad/export_assembly.py: assembled arm as coloured GLB + STL, and 5 print
    plates (3MF + STL) laid out for a 220 mm bed
    - docs/02b-amazon-de.md: amazon.de search links for every part
    - video/: renders the step-by-step build guide from the CAD parts with
    three.js in headless Chromium and encodes it with ffmpeg
    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
    [plate_1_fit_test.3mf, plate_1_fit_test.stl, plate_2_fingers.3mf, plate_2_fingers.stl, plate_3_palm.3mf, plate_3_palm.stl, plate_4_spine.3mf, plate_4_spine.stl]
2026-11-01 End-to-end validation: firmware tests, thumb sim, assembly checks
    - validate.sh runs every check: parts, hand layout, physics, firmware
    - firmware/test: compiles the sketch on the PC against stand-in ESP32
    headers (-Werror) and runs 32 behaviour tests
    - firmware: servos start one by one (avoids >3 A spike), thumb default
    travel matches its 2 joints, calibration warning about end stops
    - sim: model handles any number of joints; all 5 fingers incl. thumb pass
    - hand.py: channel clearance, elastic exits, pin access, servo lead reach
    (top servo needs a 30 cm extension - added to the shopping lists)
    - VALIDATION.md: results, fixes, limits and pre-build checklist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
    [finger_control.ino, finger_sim.py, hand.py, test_firmware.cpp]
2026-11-01 Servo extension cables are optional: jumpers already extend the leads
    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
2026-11-01 Match the ordered parts: 20 cm servo leads need 20 cm jumpers
    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
2026-11-01 Wiring: ESP32 plugs into the breadboard, male-male jumpers only
    Simpler and more robust for beginners: the 30-pin ESP32 sits across the
    breadboard groove, each servo signal goes into the free hole next to its
    pin. Guides 04/05, validation and shopping notes updated. Adds the
    narrated wiring & programming video source (video/electronics).
    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
2026-11-01 Add narrated wiring & programming video (7.7 min)
    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
2026-11-01 Spine: add a FRONT marker dot (front servos mount on this face)
    Without it the spine could be mounted back to front, which would put the
    spools out of line with the palm's string channels. STLs, plates and the
    assembly are regenerated. Adds the narration for the assembly video.
    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
    [plate_1_fit_test.3mf, plate_2_fingers.3mf, plate_3_palm.3mf, plate_4_spine.3mf, plate_4_spine.stl, plate_5_stand.3mf, robohand_assembly.stl, spine.stl]
2026-11-01 Assembly video source; guide 05 assembly order matches the video
    Front dot on the spine, pin count, wiring before spools, and wrapping
    each string in the spool's turning direction.
    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
2026-11-01 Bambu P1S print setup; printability fixes found by overhang analysis
    - spine: ribs on the back only, so the flat front prints on the bed
    (removes a 56 mm bridge / ~10,700 mm2 of support)
    - stand: straight walls (corners rounded in plan only)
    - palm: vertical wrist corners; clearance groove so the thumb no longer
    rubs the palm when its base joint bends fully
    - plates laid out for the 256 mm P1S bed (spine no longer diagonal)
    - docs/03b-bambu-p1s.md: per-plate Bambu Studio settings
    - full validate.sh re-run: all checks pass
    - adds the narrated full assembly video
    Claude-Session: https://claude.ai/code/session_016UHVJgW2w5zeEXY4wxHoiJ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
    [palm.stl, plate_1_fit_test.3mf, plate_2_fingers.3mf, plate_2_fingers.stl, plate_3_palm.3mf, plate_3_palm.stl, plate_4_spine.3mf, plate_4_spine.stl]
2026-11-03 Guide 05: pins come from printer filament; longer pins for stand and palm
    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
2026-11-03 Close-up video source: string and elastic for one finger
    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
2026-11-03 Add close-up video: string and elastic for one finger (3.9 min)
    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
2026-11-03 String anchor button: no glue, can't pull through the fingertip
    0.3 mm braided line is thin and slippery: even several knots slip through
    the 2 mm string hole. A 7 mm printed button with two holes now anchors the
    string at the fingertip (line looped around the bar between the holes).
    Adds plate 6 (8 buttons) and updates guides 03/03b.
    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
    [plate_6_string_buttons.3mf, plate_6_string_buttons.stl, string_button.stl]
2026-11-03 Fingertip cap replaces the string button
    Each fingertip gets a 6 x 3.6 mm socket at the string hole and a matching
    cap shaped to the fingertip (flush). The string loops through two holes in
    the cap and the string tension pulls the cap into its socket: no glue, no
    knot that can slip through. New plate 6: 5 fingertips + 5 caps + 2 spares.
    Collision checks re-run; all plates regenerated.
    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
    [finger_distal.stl, index_distal.stl, little_distal.stl, middle_distal.stl, plate_1_fit_test.3mf, plate_1_fit_test.stl, plate_2_fingers.3mf, plate_2_fingers.stl]
2026-11-03 Guide 03: filament toggle anchor for already-printed original fingertips
    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
2026-11-03 Elastic: knot at both ends instead of lock pins (pins don't grip)
    Found during the build: the lock pin reaches only 0.57 mm into the 2.6 mm
    elastic channel, leaving 2.03 mm for a 2.0 mm cord, so it can't squeeze.
    Simulated a continuous elastic knotted at the fingertip and palm over the
    rounded knuckles: same curl, servo load and hold-open margins as the
    per-joint locks. Guides 03/05 and VALIDATION updated; sim gains the mode.
    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
2026-11-03 Close-up video source: string toggle and knotted elastic (no glue, no lock pins)
    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
2026-11-03 Re-render close-up video: string toggle and knotted elastic
    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
2026-11-03 Add picture guide for tying the elastic knot on the back of the palm
    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
2026-11-04 Palm elastic-knot video: scene script, renderer and page; picture guide says adjust before trimming
    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
2026-11-04 Add palm elastic-knot video (2 min, narrated) and link it from the full-hand guide
    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
2026-11-04 Fix palm: re-open string and elastic holes blocked inside every knuckle fork
    The palm hull was joined to the knuckle columns after their channels were cut,
    filling ~6 mm of all 10 holes. Channels are now re-cut after joining, with a
    rounded chamber at each corner, and hand.py checks every path end to end.
    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
    [palm.stl, plate_3_palm.3mf, plate_3_palm.stl, robohand_assembly.stl]
2026-11-04 Palm: print with 10 % infill (lighter, same strength where it matters)
    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
2026-11-04 Camera in the palm: rail on the palm + ESP32-CAM cover (plate 7); whole-model fit audit
    - palm: short dovetail rail low on the inside face, where the curled fingers never
    reach (checked 0-90 deg, all fingers + thumb). Added before any hole is cut.
    - palm_camera.py: cover for an ESP32-CAM, slides onto the rail, locked by one
    filament pin, board held by rubber cords. Prints standing, no supports.
    - audit.py: probes every pin path, socket, slot and channel between parts,
    one-piece check and support analysis for every printed part. Part of validate.sh.
    - 10 % palm infill note, guide 06, shopping list, print table.
    Claude-Session: htt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
    [palm.stl, palm_camera_cover.stl, plate_3_palm.3mf, plate_3_palm.stl, plate_7_palm_camera.3mf, plate_7_palm_camera.stl, robohand_assembly.stl]
2026-11-04 Ignore generated palm-camera render data
    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
2026-11-04 Palm option A (proposed): open elastic slots + V-clips instead of hidden tunnels
    - each elastic lies in an open slot down the back of its knuckle (bend 13-15 deg
    instead of a sharp 53 deg corner) and clicks into a self-locking V-clip
    (1.0 mm narrow end = 50 % of the 2 mm cord, 3.4 mm wide end)
    - new checks use the REAL cord (2.3 mm incl. print shrink): path free, can be laid
    in from outside, clip squeezes, knot backup, string-channel walls untouched
    - audit: forks unchanged (fingers fit), additions only rail + old tunnel zones
    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
    [palm.stl, plate_3_palm.3mf, plate_3_palm.stl, robohand_assembly.stl]
2026-11-04 Palm: smooth, wider elastic tunnels (keep the palm and the knot as before)
    Undo the slot+clip proposal. The only change to the printed palm is inside the
    5 elastic tunnels: 3.4 mm hole (was 2.6), a 12 mm-radius curve (6x the cord)
    instead of the sharp 53 deg corner, a funnel at the top. The exit and the knot on
    the back of the palm stay where they were.
    Checks with the real cord (2.3 mm incl. print shrink): path free, largest kink
    4.8 deg, 0.8 mm wall complete along the tunnel, knot can't enter, string walls
    untouched. Compared with the printed palm: no change outside the tunnels.
    Claude-Session: https://claude.ai/code/session_016UHVJ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
    [palm.stl, plate_3_palm.3mf, plate_3_palm.stl, plate_7_palm_camera.3mf, robohand_assembly.stl]
2026-11-04 Palm: finger pins go in from above (slot + seat in each knuckle prong)
    The forks are 1.1-1.6 mm apart, so a 17 mm pin could not be pushed in from the
    side (middle finger blocked both sides), and sideways 1.9 mm holes printed small.
    Each prong now has a slot open at the top: pin through the finger's tab, lower the
    finger in, nudge it into a seat 1 mm deeper at the exact pivot. Thumb fork added
    once (identical shape, no duplicate faces). Nothing else changed vs the printed
    palm (only the 10 slots removed, 0.01 mm3 elsewhere).
    New checks: finger + pin lowered along the slot (no contact), pin can't lift
    straight out, verified on the exported 3MF. Flaw B11 logged.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
    [palm.stl, plate_3_palm.3mf, plate_3_palm.stl, plate_7_palm_camera.3mf, robohand_assembly.stl]
2026-11-04 Finger-pin slot video: scene script, renderer and page
    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
2026-11-04 Add finger-pin slot video (1.5 min, narrated) and link it from guide 05
    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
2026-11-05 Add docs/reference: photos of the working build and the current design pictures
    Photos re-saved without phone metadata. README lists current vs outdated
    pictures and videos so they don't get mixed up.
    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
2026-11-05 Reference README: servos not fitted yet in the side photo
    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
2026-11-10 Add 40 s servo-mounting clip (cut from the assembly video, still correct)
    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
2026-11-10 Glue-free spool (plate 8): horn pocket + lashing; fix horn hitting the next servo (B12)
    - spool_v2: cross-horn pocket under the spool, two lashing slot pairs, centre
    hole for the horn screw; same winding radius, anchor holes and string travel
    - the stock long horn arm (~17.5 mm) reached the next servo's body (15.1 mm):
    trim to 26 mm tip to tip; base disc 27 mm across with a 45 deg slope
    - checks now model the horn and turn spool + horn a full circle against every
    neighbour; horn fit test piece on plate 8
    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
    [horn_fit_test.stl, plate_1_fit_test.3mf, plate_1_fit_test.stl, plate_8_spools_no_glue.3mf, plate_8_spools_no_glue.stl, robohand_assembly.stl, servo_spool_x5.stl]
2026-11-10 Spool v2 pocket from the measured horn: straight double arm 31.3 mm (trim to 26), 5.6->3.9 mm wide, hub 7.2
    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
    [horn_fit_test.stl, plate_1_fit_test.3mf, plate_1_fit_test.stl, plate_8_spools_no_glue.3mf, plate_8_spools_no_glue.stl, robohand_assembly.stl, servo_spool_x5.stl]
2026-11-10 Spools for both horns: double-arm (plate 9) and single-arm (plate 10), fit tests on plate 8
    Both versions checked: one solid, watertight, horn sits in pocket and fit-test disc
    without forcing, lashing slot over the arm, spool + trimmed horn turned a full
    circle against every neighbour at all 5 servos, print without supports.
    Exported 3MFs verified (watertight, on the bed, fit the P1S).
    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
    [horn_fit_test.stl, horn_fit_test_single_arm.stl, plate_10_spools_single_arm.3mf, plate_10_spools_single_arm.stl, plate_1_fit_test.3mf, plate_1_fit_test.stl, plate_8_horn_fit_tests.3mf, plate_8_horn_fit_tests.stl]
2026-11-10 Spool horn pocket: more clearance + wider mouth (first-layer squash), open-ended slots, deeper pocket
    Fit test was too tight once printed (pocket faces the bed). Now 0.45 mm/side,
    first 0.4 mm another 0.4 wider, arm slots open through the rim, pocket 2.3 mm
    deep. Fixed the horn model used by the checks (was nearly empty after the depth
    change) and added sanity/control checks: horn volume, still fits a horn 0.4 mm
    thicker/wider, a 1.2 mm too-wide horn must be caught.
    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
    [horn_fit_test.stl, horn_fit_test_single_arm.stl, plate_10_spools_single_arm.3mf, plate_10_spools_single_arm.stl, plate_1_fit_test.3mf, plate_1_fit_test.stl, plate_8_horn_fit_tests.3mf, plate_8_horn_fit_tests.stl]
2026-11-10 Spool without horn (v3): presses onto the servo spline, held by the centre screw
    The builder doesn't want to trim the horns, and an untrimmed horn (15.65 mm)
    reaches the next servo's body (15.1 mm), so the horn is dropped: 21-tooth spline
    (~4.8 mm, community measurements) into a 4.6 mm socket, original centre screw
    into the threaded shaft, V string groove r 13.5 (42.7 mm pull in 180 deg).
    Checks: full-circle sweep against all neighbours also with the shaft 1 mm lower /
    0.7 mm higher than assumed; spline grip + control; prints without supports.
    Plate 8 = spline fit test (4 sizes), plate 9 = 5 spools.
    Claude-Session: https://claude.ai/co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
    [horn_fit_test.stl, horn_fit_test_single_arm.stl, plate_10_spools_single_arm.3mf, plate_10_spools_single_arm.stl, plate_1_fit_test.3mf, plate_1_fit_test.stl, plate_8_horn_fit_tests.3mf, plate_8_horn_fit_tests.stl]
2026-11-10 Spool v3: 3D views showing the rims, groove, slot, tie holes and the tied string
    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
2026-11-10 Spool socket 4.8 mm: the 4-dot fit-test hub fitted best on the real servo
    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
    [plate_1_fit_test.3mf, plate_1_fit_test.stl, plate_8_spline_fit_test.3mf, plate_9_spools.3mf, plate_9_spools.stl, robohand_assembly.stl, servo_spool_x5.stl]
2026-11-10 Spool: 6.5 mm head hole so the centre screw reaches the shaft (B13)
    The 4.6 mm hole printed smaller than the 4.5 mm screw head, so the screw sat on
    top. Now 6.5 mm (7 mm mouth). New check lowers the screw (+0.5 mm print
    allowance) to the floor and confirms 3.1 mm of thread in the shaft, with a
    control proving the probe size; it fails on the old design as it did in reality.
    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
    [plate_1_fit_test.3mf, plate_1_fit_test.stl, plate_8_spline_fit_test.3mf, plate_9_spools.3mf, plate_9_spools.stl, robohand_assembly.stl, servo_spool_x5.stl]
2026-11-11 Slimmer spool: rims 29 mm, 9 mm hub at the servo (spools rubbed on the motors, B14)
    Screw system unchanged (socket 4.8, floor, 6.5 mm head hole: 0.16 mm3 difference =
    tessellation), groove at the same height, 41.9 mm string pull in 180 deg.
    Checks: rims 0.6 mm inside the 15.1 mm to the next servo regardless of the axial
    gap, full-circle sweep with the shaft up to 2 mm lower, measured on the 3MF.
    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
    [plate_1_fit_test.3mf, plate_1_fit_test.stl, plate_8_spline_fit_test.3mf, plate_9_spools.3mf, plate_9_spools.stl, robohand_assembly.stl, servo_spool_x5.stl]
2026-11-11 Electronics review: safe default closing angles, power-on order, double power jumpers
    - firmware: fingers default to 150 deg (~88 % closed) until calibrated; with the
    13.35 mm spool groove full curl is ~161 deg, the old 175 would drive all fingers
    into their end stops (stall current > 3 A)
    - firmware test: defaults stay short of the end stops (old 175 fails = control),
    no servo on a boot-strapping pin
    - guides 04/05: 5 V supply first then USB (start-up stagger), 2 jumpers per power
    line, never D12, pin-14 twitch at boot is normal, calibrate before gestures
    - reference README: the wiring video's two outdated points
    Claude-Sessio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
    [finger_control.ino, test_firmware.cpp]
2026-11-11 Spine check picture: which side each servo's spool goes on (B15)
    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
2026-11-11 Add step picture: tying the finger string to spool v3 with a filament toggle
    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
